ContextualElectronics/BenchBudEE/CE-2line.bmp

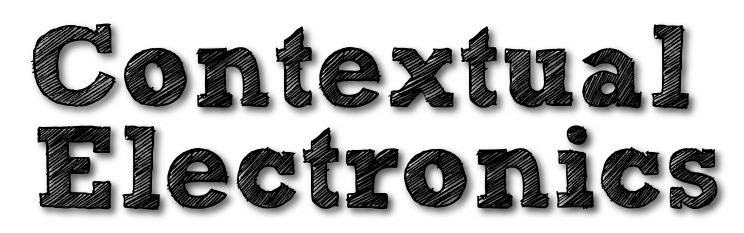
CE-2line.bmp
