ContextualElectronics/BenchBudEE/BenchBudEE_BOM_Passive.xlsx

Value | Quantity | RefDes | FootPrint | Link
100P | 1 | C1 | SM0805 | http://www.digikey.com/scripts/DkSearch/dksus.dll?Detail&itemSeq=148418893&uq=635333707511717488
1U | 10 | C5 C6 C7 C8 C9 C10 C11 C12 C13 C33 | SM0805 | http://www.digikey.com/scripts/DkSearch/dksus.dll?Detail&itemSeq=148418894&uq=635333707511717488
10U | 8 | C14 C15 C16 C17 C22 C23 C24 C25 | SM0805 | http://www.digikey.com/scripts/DkSearch/dksus.dll?Detail&itemSeq=148418891&uq=635333707511717488
.01U | 4 | C18 C19 C20 C21 | SM0805 | http://www.digikey.com/scripts/DkSearch/dksus.dll?Detail&itemSeq=148418892&uq=635333707511717488
NOPOP | 5 | C30 C31 C32 R26 R57 | SM0805 | -
10U | 7 | C2 C3 C4 C26 C27 C28 C29 | SM1206 | http://www.digikey.com/scripts/DkSearch/dksus.dll?Detail&itemSeq=148418896&uq=635333707511717488
Ferrite Bead | 1 | L5 | SM0805 | http://www.digikey.com/scripts/DkSearch/dksus.dll?Detail&itemSeq=148416636&uq=635333682965213087
0 | 33 | R3 R5 R6 R14 R15 R43 R48 R49 R56 R58 R61 R62 R63 R27 R28 R29 R30 R31 R32 R33 R34 R35 R36 R37 R38 R39 R40 R41 R42 R46 R47 R50 R51 | SM0805 | http://www.digikey.com/scripts/DkSearch/dksus.dll?Detail&itemSeq=148418897&uq=635333707511717488
1 | 1 | R16 | SM1206-NO | http://www.digikey.com/scripts/DkSearch/dksus.dll?Detail&itemSeq=148418899&uq=635333707511717488
10 | 1 | R44 | SM0805 | http://www.digikey.com/scripts/DkSearch/dksus.dll?Detail&itemSeq=148418903&uq=635333707511717488
15 | 1 | R17 | SM0805 | http://www.digikey.com/scripts/DkSearch/dksus.dll?Detail&itemSeq=148418900&uq=635333707511717488
100 | 2 | R45 | SM0805 | http://www.digikey.com/scripts/DkSearch/dksus.dll?Detail&itemSeq=148418902&uq=635333707511717488
100 | 2 | R4 | SM0805 | http://www.digikey.com/scripts/DkSearch/dksus.dll?Detail&itemSeq=148418904&uq=635333707511717488
200 | 2 | R1 R2 | SM0805 | http://www.digikey.com/scripts/DkSearch/dksus.dll?Detail&itemSeq=148418901&uq=635333707511717488
715 | 2 | R18 R21 | SM0805 | http://www.digikey.com/scripts/DkSearch/dksus.dll?Detail&itemSeq=148418889&uq=635333707511717488
1000 | 1 | R12 | SM0805 | http://www.digikey.com/scripts/DkSearch/dksus.dll?Detail&itemSeq=148418898&uq=635333707511717488
1K | 4 | R22 R25 R59 R60 | SM0805 | http://www.digikey.com/scripts/DkSearch/dksus.dll?Detail&itemSeq=148418907&uq=635333707511717488
1.3K | 2 | R53 R54 | SM0805 | http://www.digikey.com/scripts/DkSearch/dksus.dll?Detail&itemSeq=148418911&uq=635333707511717488
3K | 2 | R23 R24 | SM0805 | http://www.digikey.com/scripts/DkSearch/dksus.dll?Detail&itemSeq=148418906&uq=635333707511717488
4.99K | 2 | R11 R13 | SM0805 | OOPS
4.99K | 2 | R7 R8 | SM1206 | http://www.digikey.com/scripts/DkSearch/dksus.dll?Detail&itemSeq=148418908&uq=635333707511717488
9.1K | 2 | R52 R55 | SM0805 | http://www.digikey.com/scripts/DkSearch/dksus.dll?Detail&itemSeq=148418910&uq=635333707511717488
200K | 2 | R9 R10 | SM1206 | http://www.digikey.com/scripts/DkSearch/dksus.dll?Detail&itemSeq=148418914&uq=635333707511717488
.1UF | 0 | None | SM0805 | http://www.digikey.com/scripts/DkSearch/dksus.dll?Detail&itemSeq=148418895&uq=635333707511717488
