ContextualElectronics/BenchBudEE/SPICE/InAmp.asc

R1: res; 5K
R2: res; 200K
R3: res; 5K
R4: res; 200K
R5: res; 5K
R6: res; 10
R7: res; 5K
R8: res; 10MEG
U1: LT1001
U2: LT1001
U3: LT1001
V1: voltage; SINE(0 .02 5)
V2: voltage; 12
V3: voltage; 12
Named nets: 10V+, 10V-, 0, OUT
.tran 0 1 0
.step param V 0 0.031 0.005
1000 ohm Rg = 1.75 V
100 ohm Rg = .200 V
10 ohm  Rg = .020V
No Rg = 10V
