ContextualElectronics/BenchBudEE/SPICE/RelayCircuit.asc

D1: LED; W5AP-LZMZ-5K8L
L1: ind; .1µ
Q1: npn; 2N3904
R1: res; 100
R2: res; 200
R3: res; 0.01
R4: res; 10
V1: voltage; 12
V2: voltage; PULSE(0 12 .1 .01 .01 1 1 10)
Named nets: 0
.tran 0 .2 0
