ContextualElectronics/BenchBudEE/SPICE/CurrentSource.asc

C1: cap; 10n
D1: diode; 1N914
M1: nmos; BSB012NE2LX
M3: nmos; Si7540DP_N
M4: nmos; Si7540DP_N
R1: res; 40
R2: res; 2
R5: res; 1K
R6: res; 2
U1: LT1001
V1: voltage; 12
V2: voltage; 12
V3: voltage; PULSE(4 0 100m .1m .1m 50m)
V4: voltage; 5
V5: voltage; PULSE(0 5 0 .1m .1m 1m 2m 10000)
V6: voltage; 5
Named nets: 0, V+, V-, FET, Sense, 5V, MODE, DAC, PWM
.tran 0 .1 0
.STEP PARAM Rload 2 20 2
.PARAM Rload 2
