ContextualElectronics/BenchBudEE/BenchBuddy.kicad_pcb

## KiCad design BenchBuddy.kicad_pcb (2014-03-04)

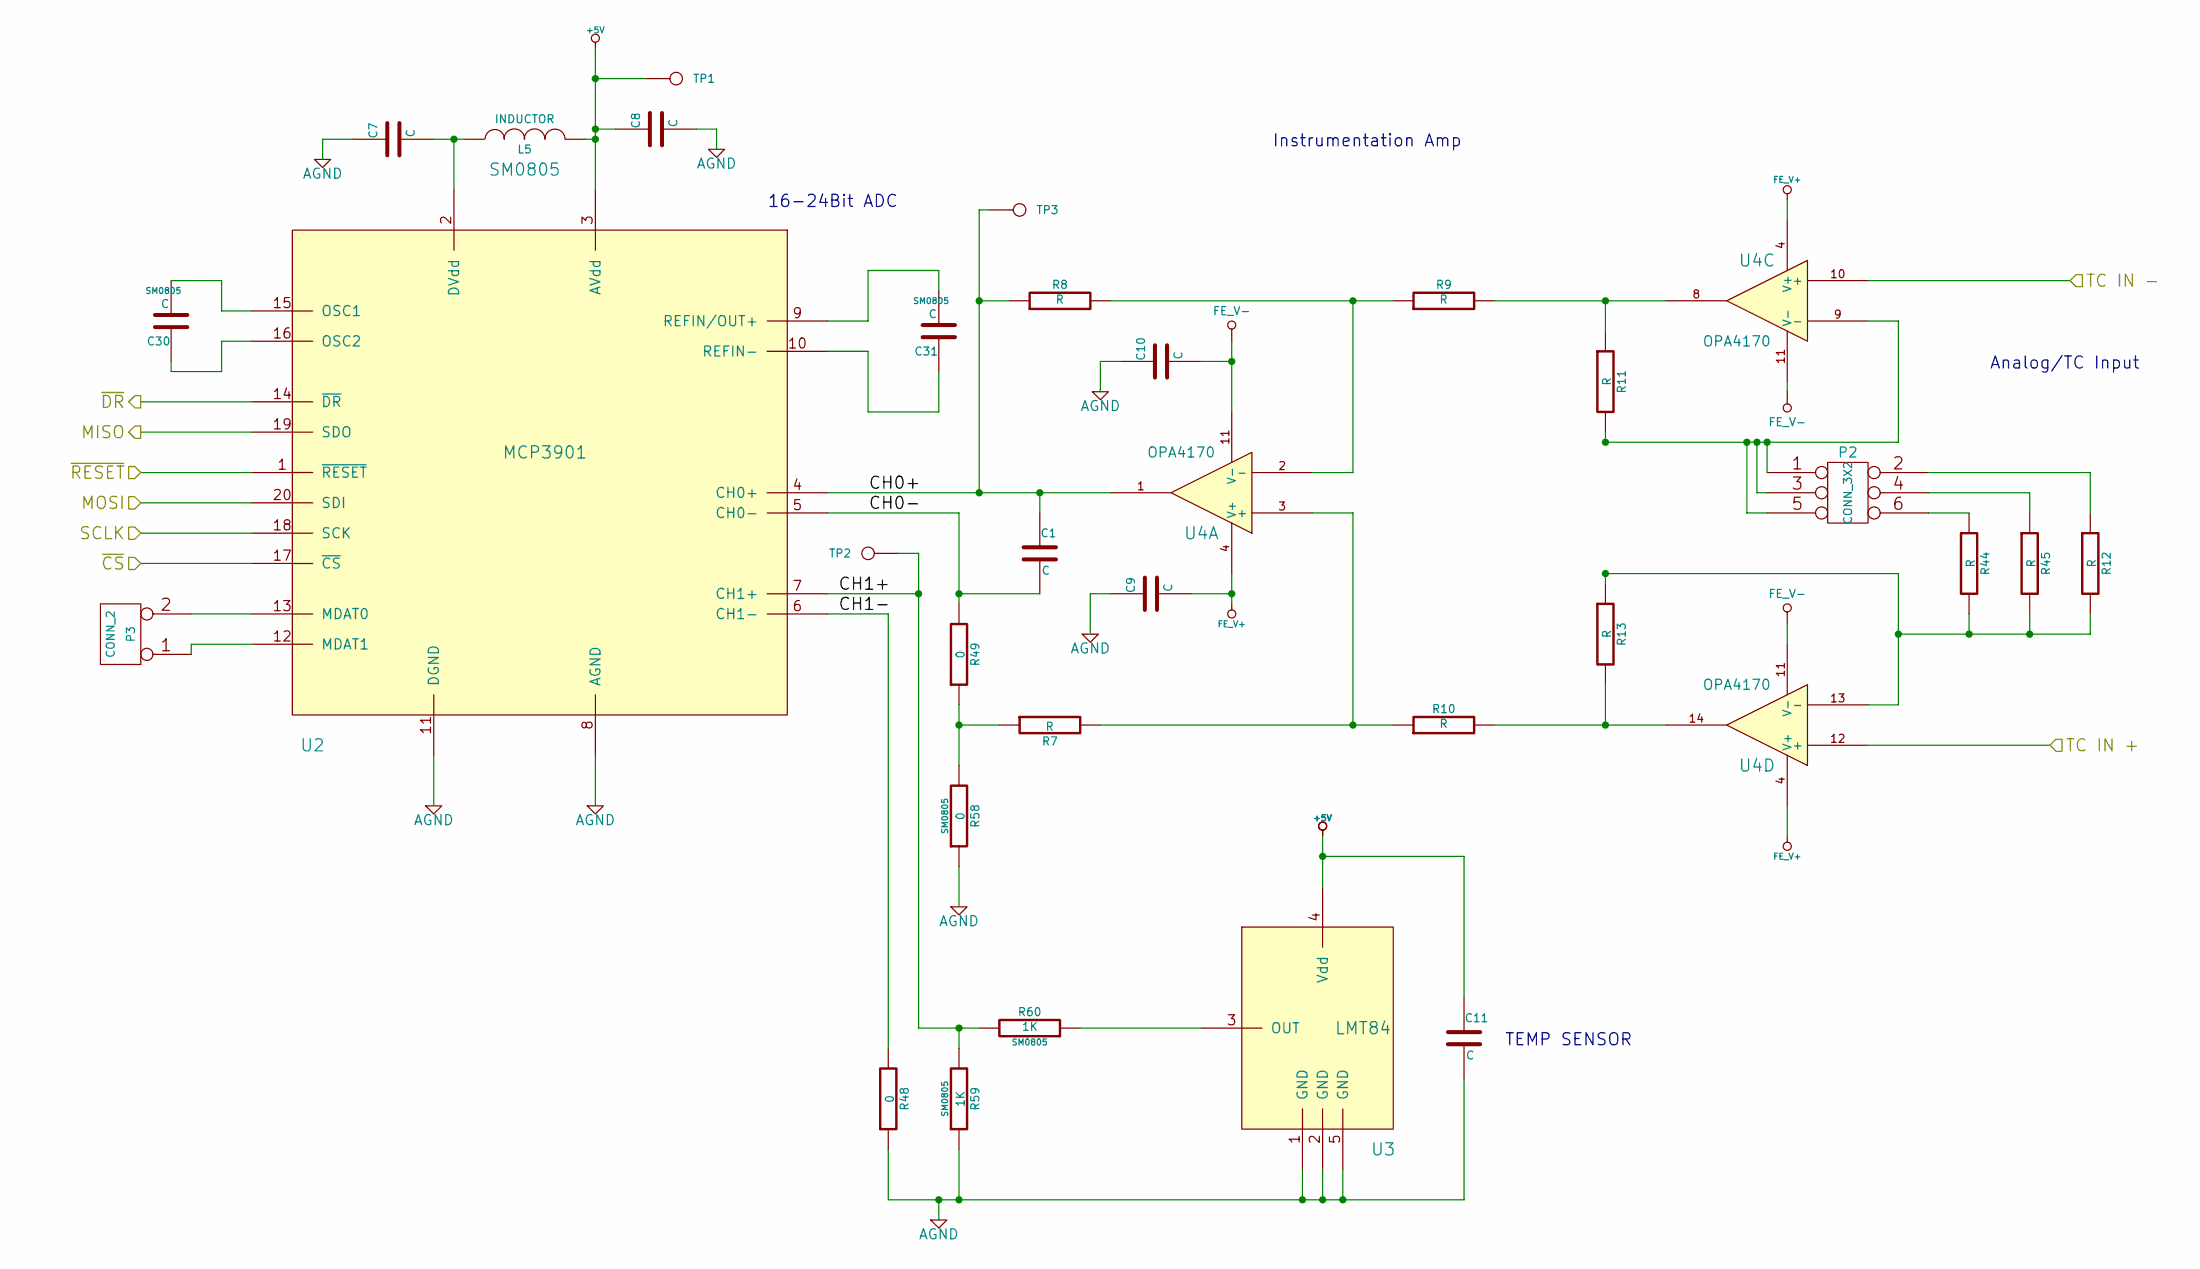
[picture p2: schematic Thermocouple.sch]

Parts:
C1, C7, C8, C9, C10, C11: C
C30, C31: C; SM0805
L5: INDUCTOR; SM0805
P2: CONN_3X2
P3: CONN_2
R7, R8, R9, R10, R11, R12, R13, R44, R45: R
R48, R49: 0
R58: 0; SM0805
R59, R60: 1K; SM0805
TP1: 5V
TP2: CH1
TP3: CH0
U2: MCP3901
U3: LMT84
U4: OPA4170

Connections:
+5V: C8.1, C11.1, L5.2, TP1.1, U2.3 (AVdd), U3.4 (Vdd); also elsewhere on the board
/Arduino/MISO: U2.19 (SDO); also elsewhere on the board
/Arduino/MOSI: U2.20 (SDI); also elsewhere on the board
/Arduino/SCLK: U2.18 (SCK); also elsewhere on the board
/Arduino/~ADC_CS: U2.17 (~CS); also elsewhere on the board
/Arduino/~DR: U2.14 (~DR); also elsewhere on the board
/Arduino/~RESET: U2.1 (~RESET); also elsewhere on the board
/Thermocouple/CH0+: C1.1, R8.1, TP3.1, U2.4 (CH0+), U4.1
/Thermocouple/CH0-: C1.2, R49.2, U2.5 (CH0-)
/Thermocouple/CH1+: R59.2, R60.2, TP2.1, U2.7 (CH1+)
/Thermocouple/CH1-: R48.2, U2.6 (CH1-)
/Thermocouple/TC IN +: U4.12 (+); also elsewhere on the board
/Thermocouple/TC IN -: U4.10 (+); also elsewhere on the board
AGND: C7.1, C8.2, C9.1, C10.1, C11.2, R48.1, R58.1, R59.1, U2.8 (AGND), U2.11 (DGND), U3.1 (GND), U3.2 (GND), U3.5 (GND); also elsewhere on the board
FE_V+: C9.2, U4.4 (V+); also elsewhere on the board
FE_V-: C10.2, U4.11 (V-); also elsewhere on the board
unnamed: R60.1, U3.3 (OUT)
unnamed: C30.2, U2.15 (OSC1)
unnamed: C30.1, U2.16 (OSC2)
unnamed: C31.2, U2.9 (REFIN/OUT+)
unnamed: C31.1, U2.10 (REFIN-)
unnamed: P3.1, U2.12 (MDAT1)
unnamed: P2.2, R12.1
unnamed: P2.4, R45.1
unnamed: P2.6, R44.1
unnamed: R8.2, R9.1, U4.2 (-)
unnamed: R7.2, R10.1, U4.3 (+)
unnamed: R9.2, R11.1, U4.8
unnamed: P2.1, P2.3, P2.5, R11.2, U4.9 (-)
unnamed: R12.2, R13.1, R44.2, R45.2, U4.13 (-)
unnamed: R10.2, R13.2, U4.14
unnamed: P3.2 (PM), U2.13 (MDAT0)
unnamed: R7.1, R49.1, R58.2
unnamed: C7.2, L5.1, U2.2 (DVdd)

Notes on the sheet:
Analog/TC Input
Instrumentation Amp
16-24Bit ADC
TEMP SENSOR

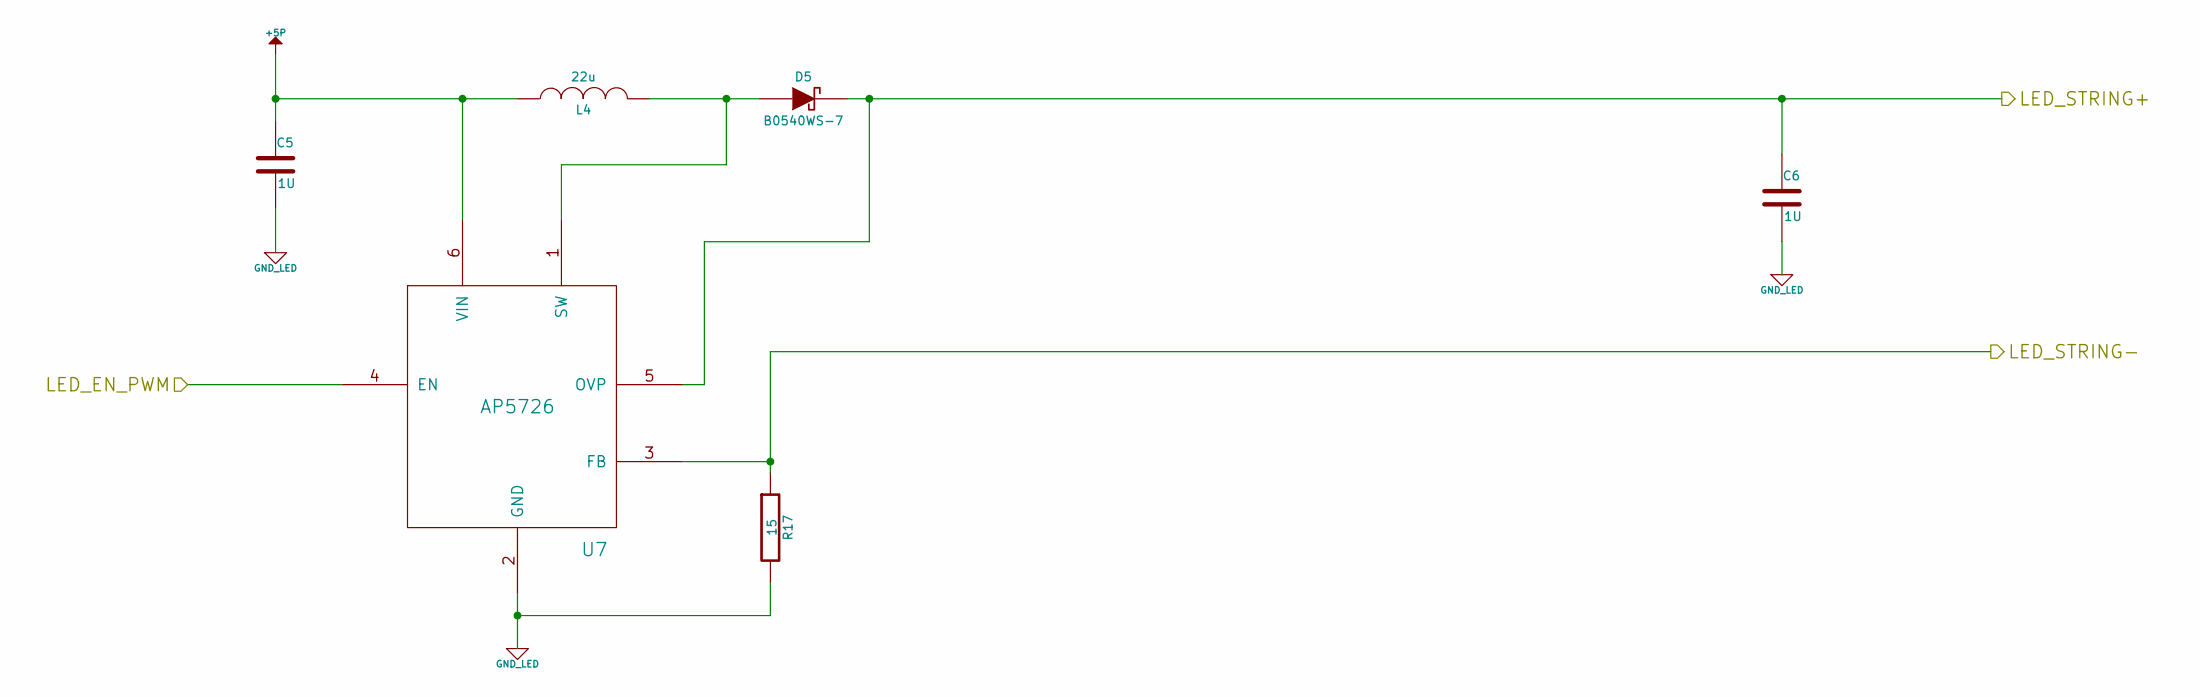
[picture p3: schematic LED_Driver.sch]

Parts:
C5, C6: 1U
D5: B0540WS-7
L4: 22u; MFG Part Number NR4012T220M
R17: 15
U7: AP5726

Connections:
+5P: C5.1, L4.1, U7.6 (VIN); also elsewhere on the board
/Arduino/LED_EN_PWM: U7.4 (EN); also elsewhere on the board
/LED_Driver/LED_STRING+: C6.1, D5.2 (K), U7.5 (OVP); also elsewhere on the board
/LED_Driver/LED_STRING-: R17.1, U7.3 (FB); also elsewhere on the board
GND_LED: C5.2, C6.2, R17.2, U7.2 (GND); also elsewhere on the board
unnamed: D5.1 (A), L4.2, U7.1 (SW)

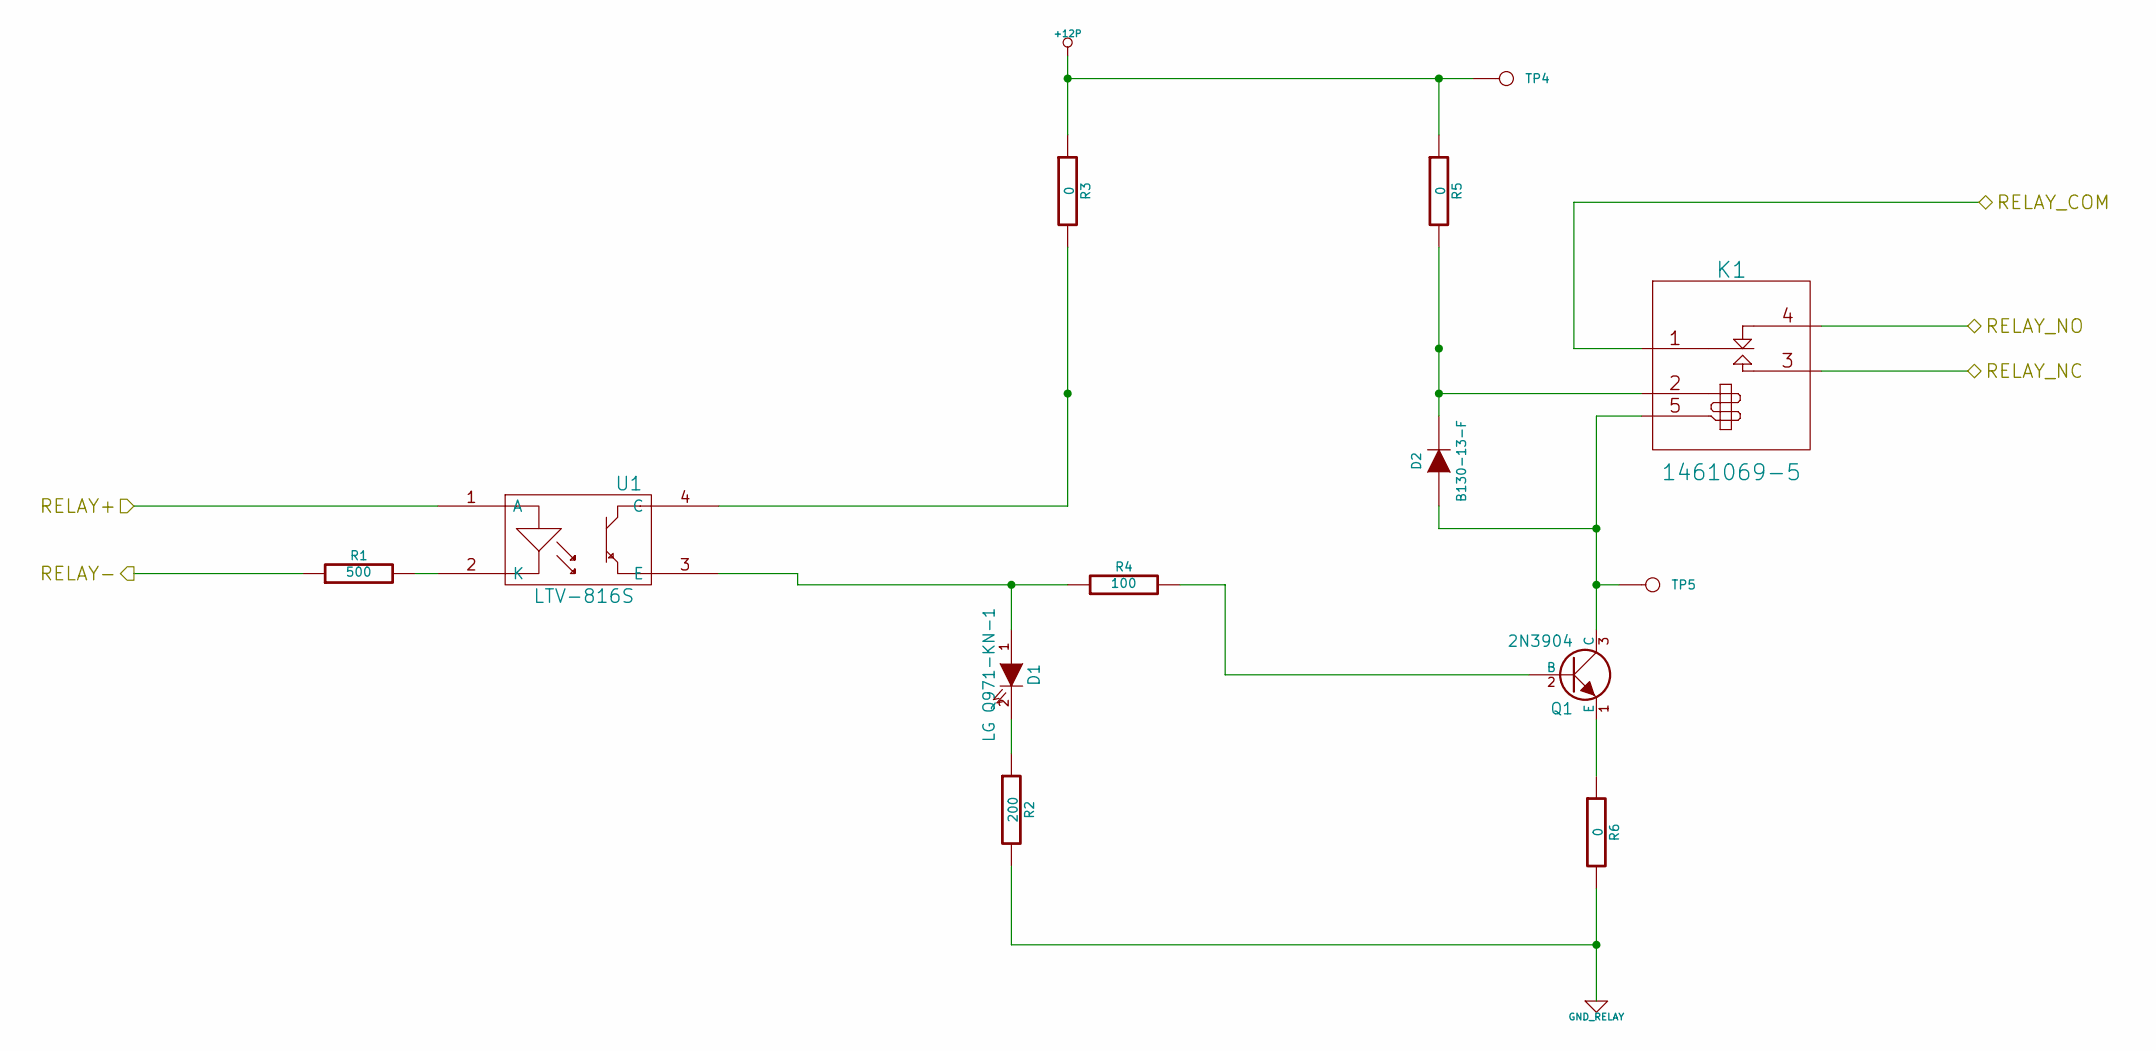
[picture p4: schematic Relay.sch]

Parts:
D1: LG Q971-KN-1
D2: B130-13-F
K1: 1461069-5
Q1: 2N3904; MFG Part Number MMBT3904-7-F
R1: 500
R2: 200
R3, R5, R6: 0
R4: 100
TP4: +12P
TP5: RELAY_LOW
U1: LTV-816S; MFG Part Number LTV-816S

Connections:
+12P: R3.1, R5.1, TP4.1; also elsewhere on the board
/Arduino/RELAY+: U1.1 (A); also elsewhere on the board
/Arduino/RELAY-: R1.1; also elsewhere on the board
/Relay/RELAY_COM: K1.1 (COM); also elsewhere on the board
/Relay/RELAY_NC: K1.3 (NO); also elsewhere on the board
/Relay/RELAY_NO: K1.4 (NC); also elsewhere on the board
GND_RELAY: R2.2, R6.2; also elsewhere on the board
unnamed: D1.2 (K), R2.1
unnamed: Q1.1 (E), R6.1
unnamed: Q1.2 (B), R4.2
unnamed: R1.2, U1.2 (K)
unnamed: D2.1 (A), K1.5 (COIL-), Q1.3 (C), TP5.1
unnamed: D2.2 (K), K1.2 (COIL+), R5.2
unnamed: D1.1 (A), R4.1, U1.3 (E)
unnamed: R3.2, U1.4 (C)

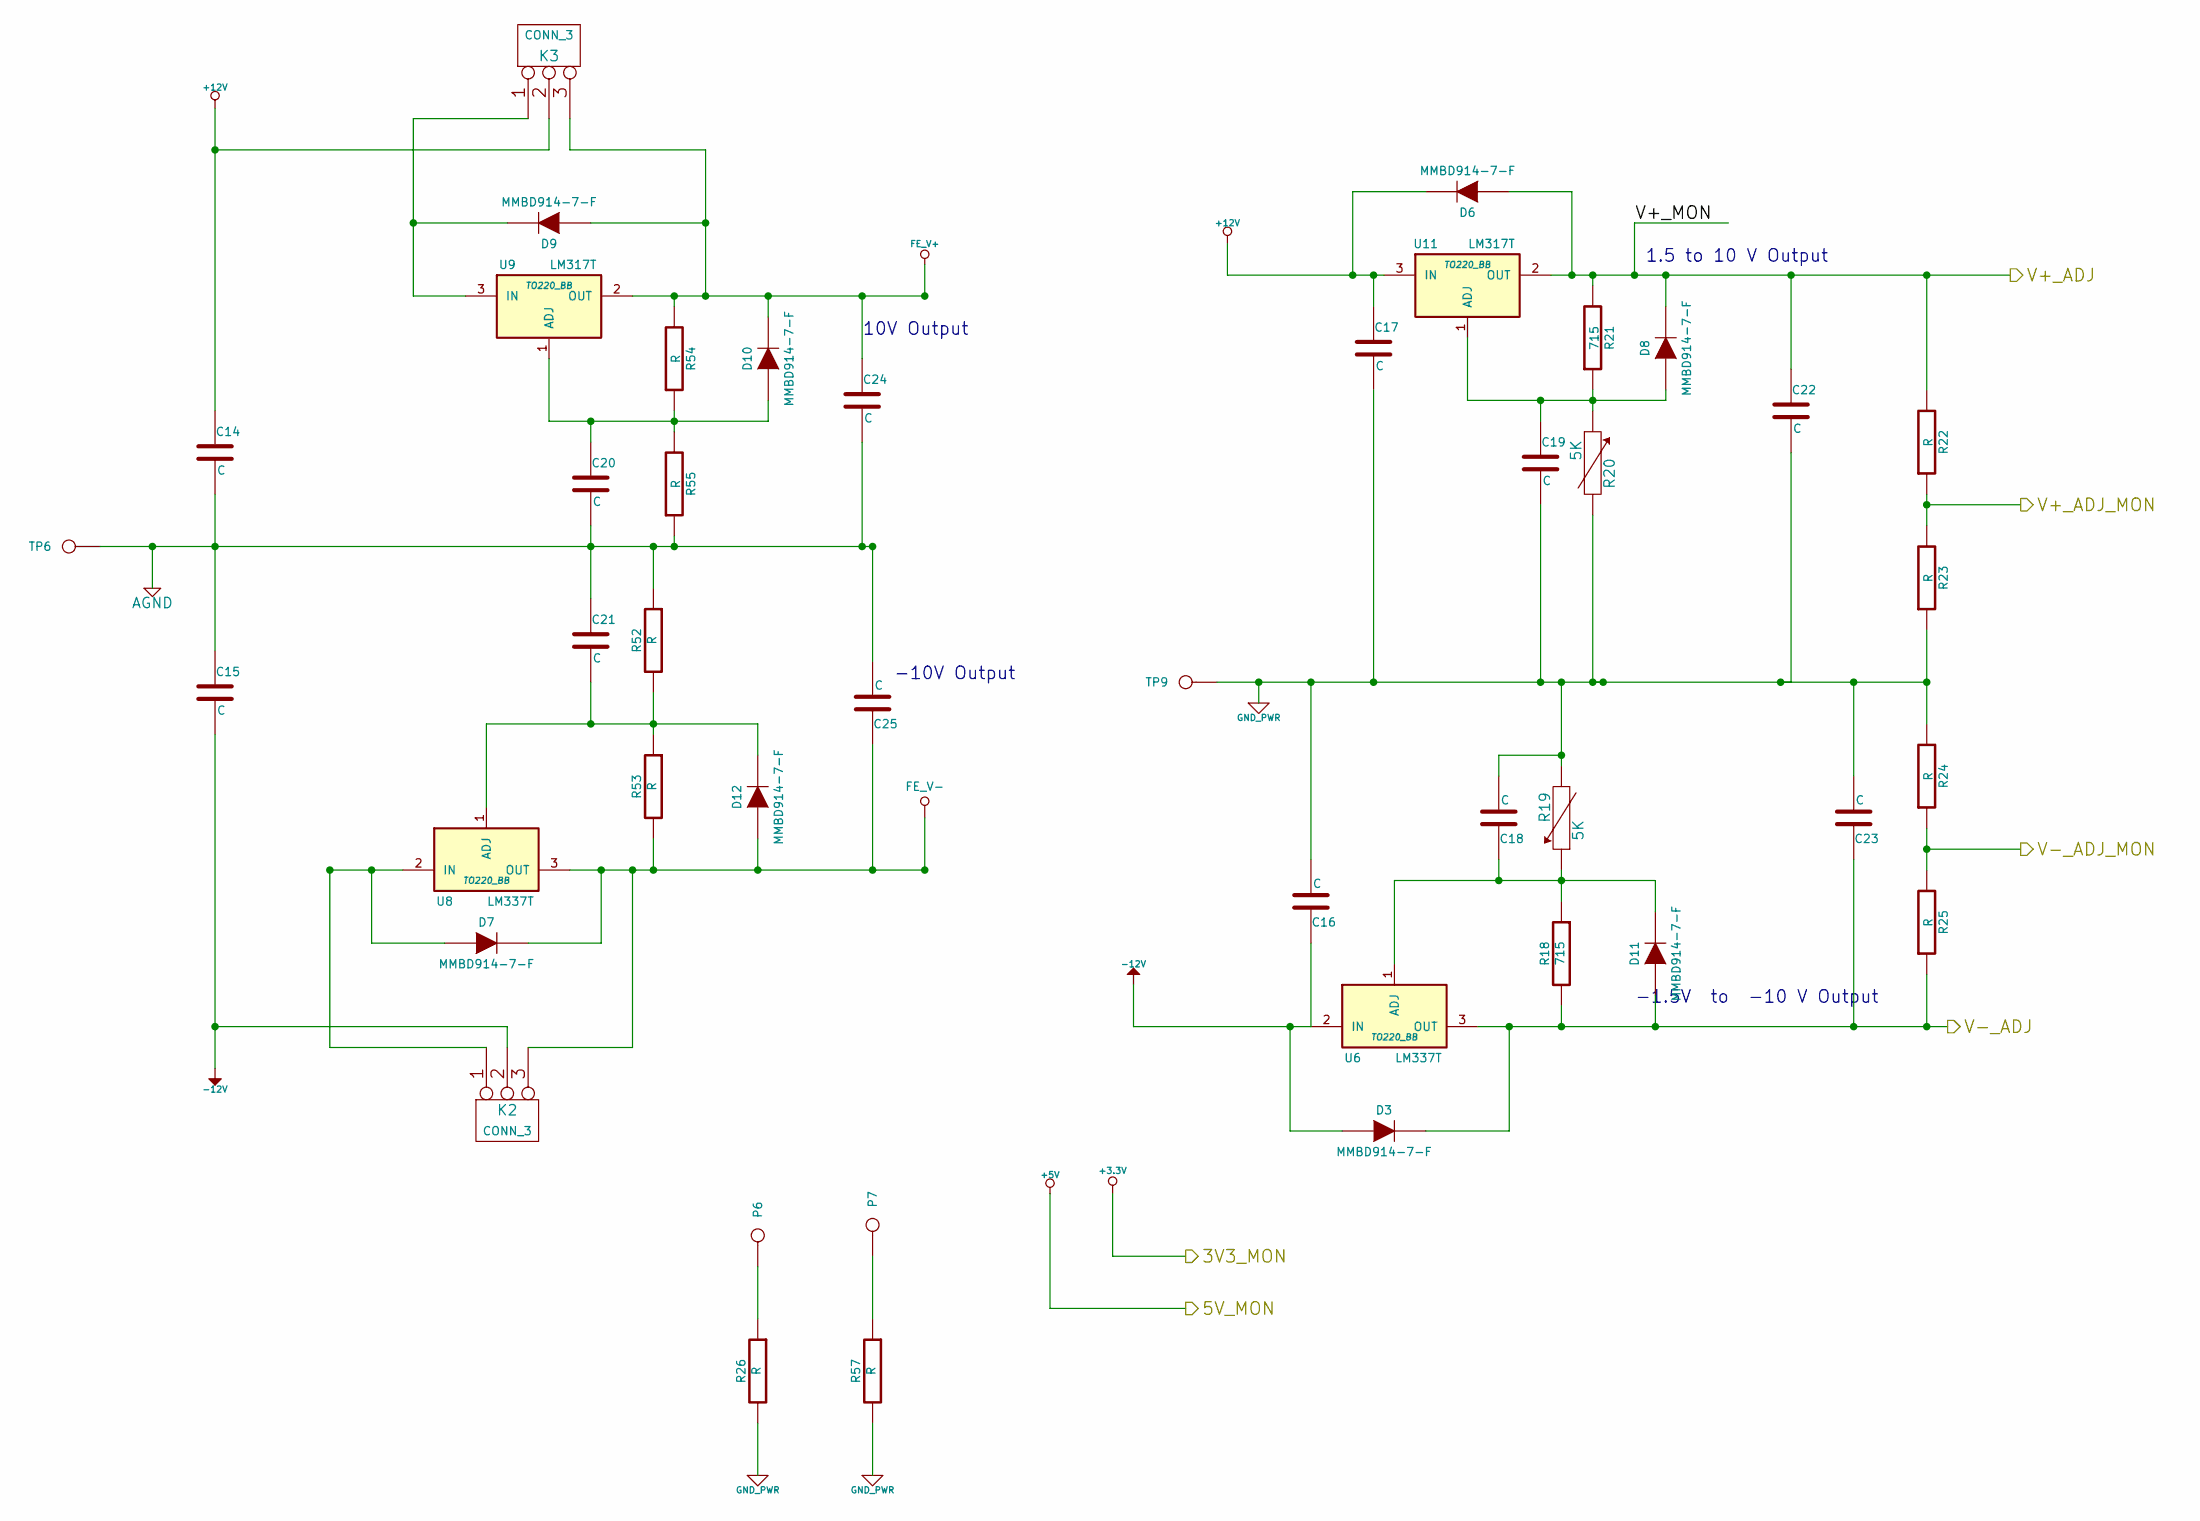
[picture p5: schematic PowerAdjustmentMonitor.sch]

Parts:
C14, C15, C16, C17, C18, C19, C20, C21, C22, C23, C24, C25: C
D3, D6, D7, D8, D9, D10, D11, D12: MMBD914-7-F
K2, K3: CONN_3
P6, P7: CONN_1
R18, R21: 715
R19, R20: 5K
R22, R23, R24, R25, R26, R52, R53, R54, R55, R57: R
TP6: AGND
TP9: GND_PWR
U6, U8: LM337T; TO220_BB
U9, U11: LM317T; TO220_BB

Connections:
+12V: C14.1, C17.1, D6.2 (K), K3.2 (PM), U11.3 (IN); also elsewhere on the board
-12V: C15.2, C16.1, D3.1 (A), K2.2 (PM), U6.2 (IN); also elsewhere on the board
/Arduino/V+_ADJ_MON: R22.1, R23.2; also elsewhere on the board
/Arduino/V-_ADJ_MON: R24.1, R25.2; also elsewhere on the board
/PowerAdjustmentMonitor/V+_ADJ: C22.1, D6.1 (A), D8.2 (K), R21.2, R22.2, U11.2 (OUT); also elsewhere on the board
/PowerAdjustmentMonitor/V-_ADJ: C23.1, D3.2 (K), D11.1 (A), R18.2, R25.1, U6.3 (OUT); also elsewhere on the board
AGND: C14.2, C15.1, C20.2, C21.1, C24.2, C25.2, R52.1, R55.1, TP6.1; also elsewhere on the board
FE_V+: C24.1, D9.1 (A), D10.2 (K), K3.3, R54.2, U9.2 (OUT); also elsewhere on the board
FE_V-: C25.1, D7.2 (K), D12.1 (A), K2.3, R53.2, U8.3 (OUT); also elsewhere on the board
GND_PWR: C16.2, C17.2, C18.2, C19.2, C22.2, C23.2, R19.2, R20.2, R23.1, R24.2, R26.2, R57.2, TP9.1; also elsewhere on the board
unnamed: C19.1, D8.1 (A), R20.1, R21.1, U11.1 (ADJ)
unnamed: C20.1, D10.1 (A), R54.1, R55.2, U9.1 (ADJ)
unnamed: C21.2, D12.2 (K), R52.2, R53.1, U8.1 (ADJ)
unnamed: P6.1, R26.1
unnamed: P7.1, R57.1
unnamed: C18.1, D11.2 (K), R18.1, R19.1, U6.1 (ADJ)
unnamed: D9.2 (K), K3.1, U9.3 (IN)
unnamed: D7.1 (A), K2.1, U8.2 (IN)

Notes on the sheet:
10V Output
1.5 to 10 V Output
-10V Output
-1.5V to -10 V Output

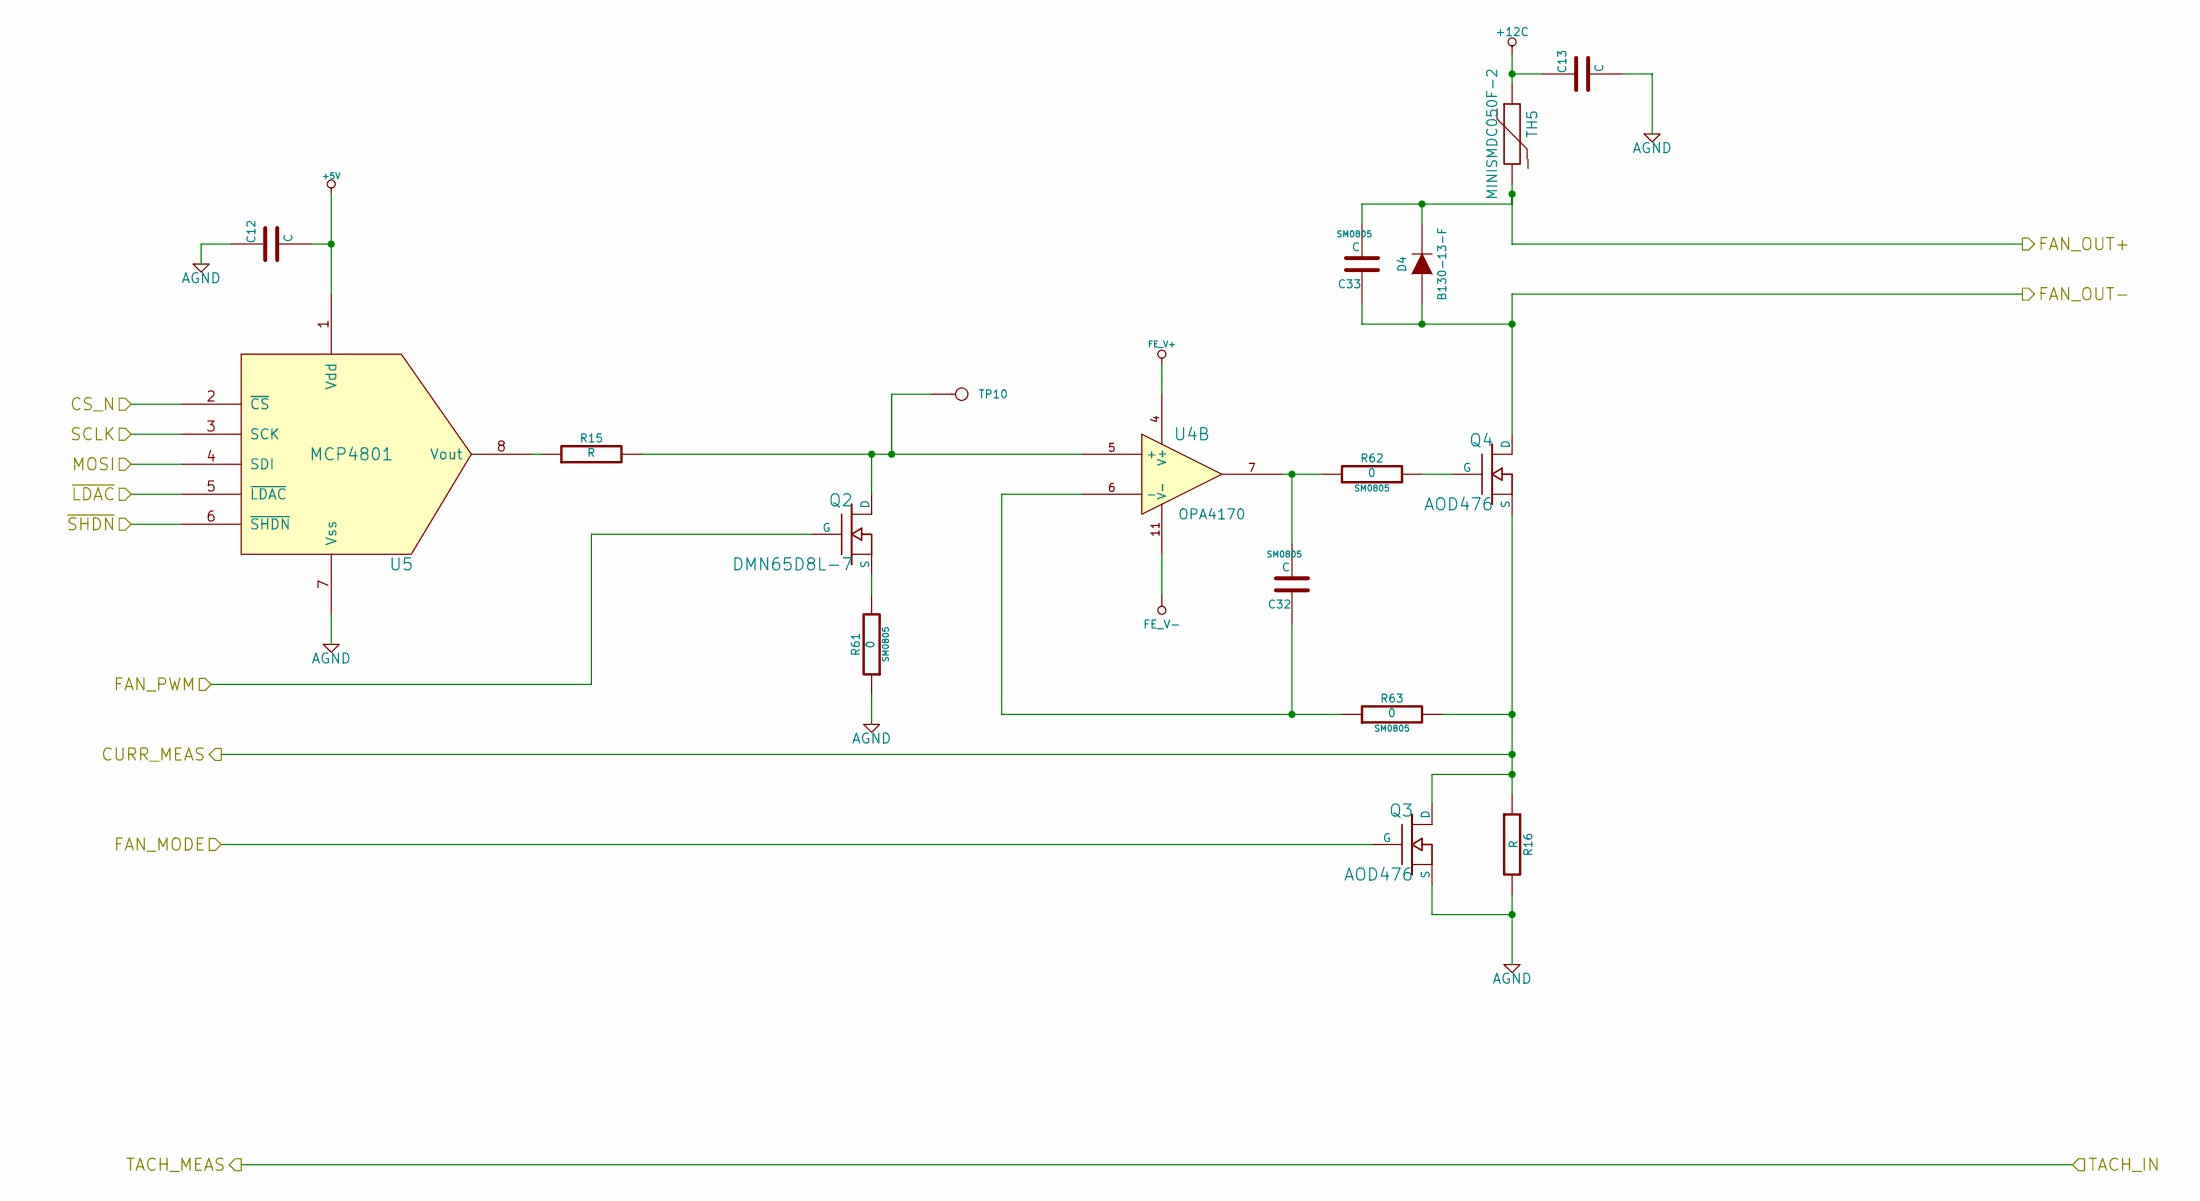
[picture p6: schematic Fan.sch]

Parts:
C12, C13: C
C32, C33: C; SM0805
D4: B130-13-F; MFG Part Number B130-13-F
Q2: DMN65D8L-7; MFG Part Number DMN65D8L-7
Q3, Q4: AOD476; MFG Part Number AOD476
R15, R16: R
R61, R62, R63: 0; SM0805
TH5: MINISMDC050F-2; MFG Part Number MINISMDC050F-2
TP10: DAC_OUT
U4: OPA4170
U5: MCP4801

Connections:
+5V: C12.2, U5.1 (Vdd); also elsewhere on the board
+12C: C13.1, TH5.1; also elsewhere on the board
/Arduino/CURR_MEAS: Q3.2 (D), Q4.3 (S), R16.1, R63.2; also elsewhere on the board
/Arduino/FAN_MODE: Q3.1 (G); also elsewhere on the board
/Arduino/FAN_PWM: Q2.G; also elsewhere on the board
/Arduino/MOSI: U5.4 (SDI); also elsewhere on the board
/Arduino/SCLK: U5.3 (SCK); also elsewhere on the board
/Arduino/~LDAC: U5.5 (~LDAC); also elsewhere on the board
/Arduino/~SHDN: U5.6 (~SHDN); also elsewhere on the board
/Fan/CS_N: U5.2 (~CS); also elsewhere on the board
/Fan/FAN_OUT+: C33.2, D4.2 (K), TH5.2; also elsewhere on the board
/Fan/FAN_OUT-: C33.1, D4.1 (A), Q4.2 (D); also elsewhere on the board
AGND: C12.1, C13.2, Q3.3 (S), R16.2, R61.1, U5.7 (Vss); also elsewhere on the board
FE_V+: U4.4 (V+); also elsewhere on the board
FE_V-: U4.11 (V-); also elsewhere on the board
unnamed: Q2.3 (S), Q2.S, R61.2
unnamed: Q4.1 (G), R62.2
unnamed: C32.1, R63.1, U4.6 (-)
unnamed: C32.2, R62.1, U4.7
unnamed: R15.1, U5.8 (Vout)
unnamed: Q2.2 (D), Q2.D, R15.2, TP10.1, U4.5 (+)

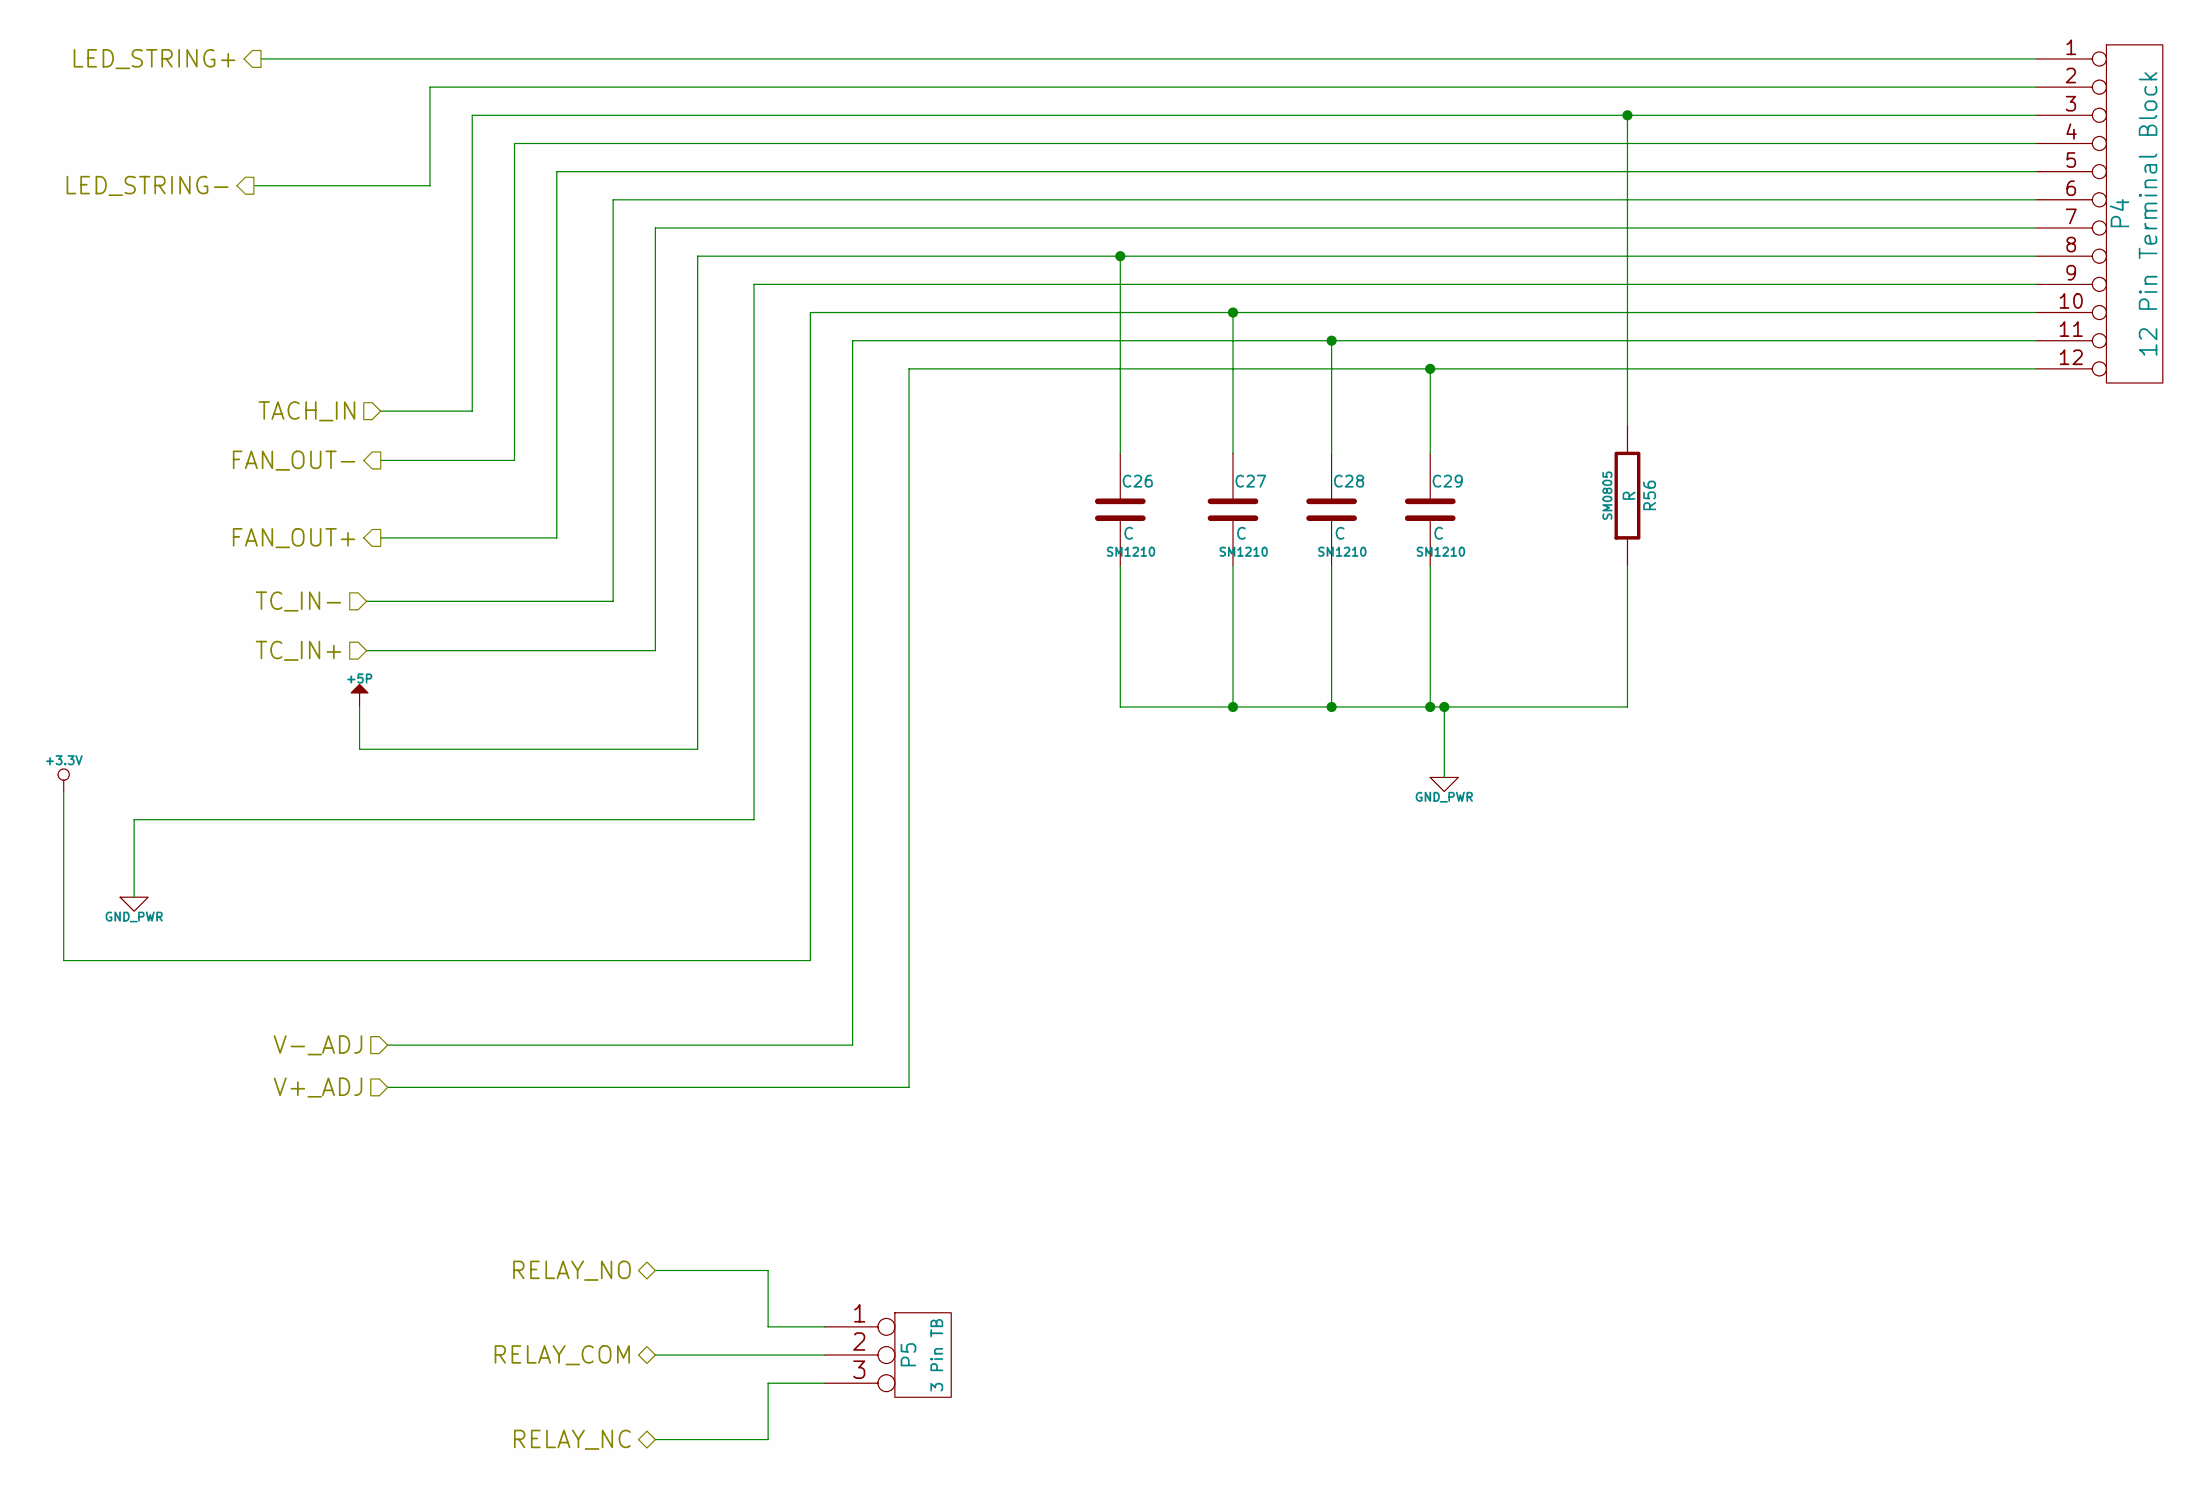
[picture p7: schematic TerminalBlock.sch]

Parts:
C26, C27, C28, C29: C; SM1210
P4: 12 Pin Terminal Block; MFG Part Number OSTTE120104
P5: 3 Pin TB; MFG Part Number 1935174
R56: R; SM0805

Connections:
+3.3V: C27.1, P4.10; also elsewhere on the board
+5P: C26.1, P4.8; also elsewhere on the board
/Fan/FAN_OUT+: P4.5; also elsewhere on the board
/Fan/FAN_OUT-: P4.4; also elsewhere on the board
/Fan/TACH_IN: P4.3, R56.2; also elsewhere on the board
/LED_Driver/LED_STRING+: P4.1; also elsewhere on the board
/LED_Driver/LED_STRING-: P4.2; also elsewhere on the board
/PowerAdjustmentMonitor/V+_ADJ: C29.1, P4.12; also elsewhere on the board
/PowerAdjustmentMonitor/V-_ADJ: C28.1, P4.11; also elsewhere on the board
/Relay/RELAY_COM: P5.2 (PM); also elsewhere on the board
/Relay/RELAY_NC: P5.3; also elsewhere on the board
/Relay/RELAY_NO: P5.1; also elsewhere on the board
/Thermocouple/TC IN +: P4.7; also elsewhere on the board
/Thermocouple/TC IN -: P4.6; also elsewhere on the board
GND_PWR: C26.2, C27.2, C28.2, C29.2, P4.9, R56.1; also elsewhere on the board
