ContextualElectronics/BenchBudEE/BenchBuddy.kicad_pcb

## KiCad design BenchBuddy.kicad_pcb (continued)

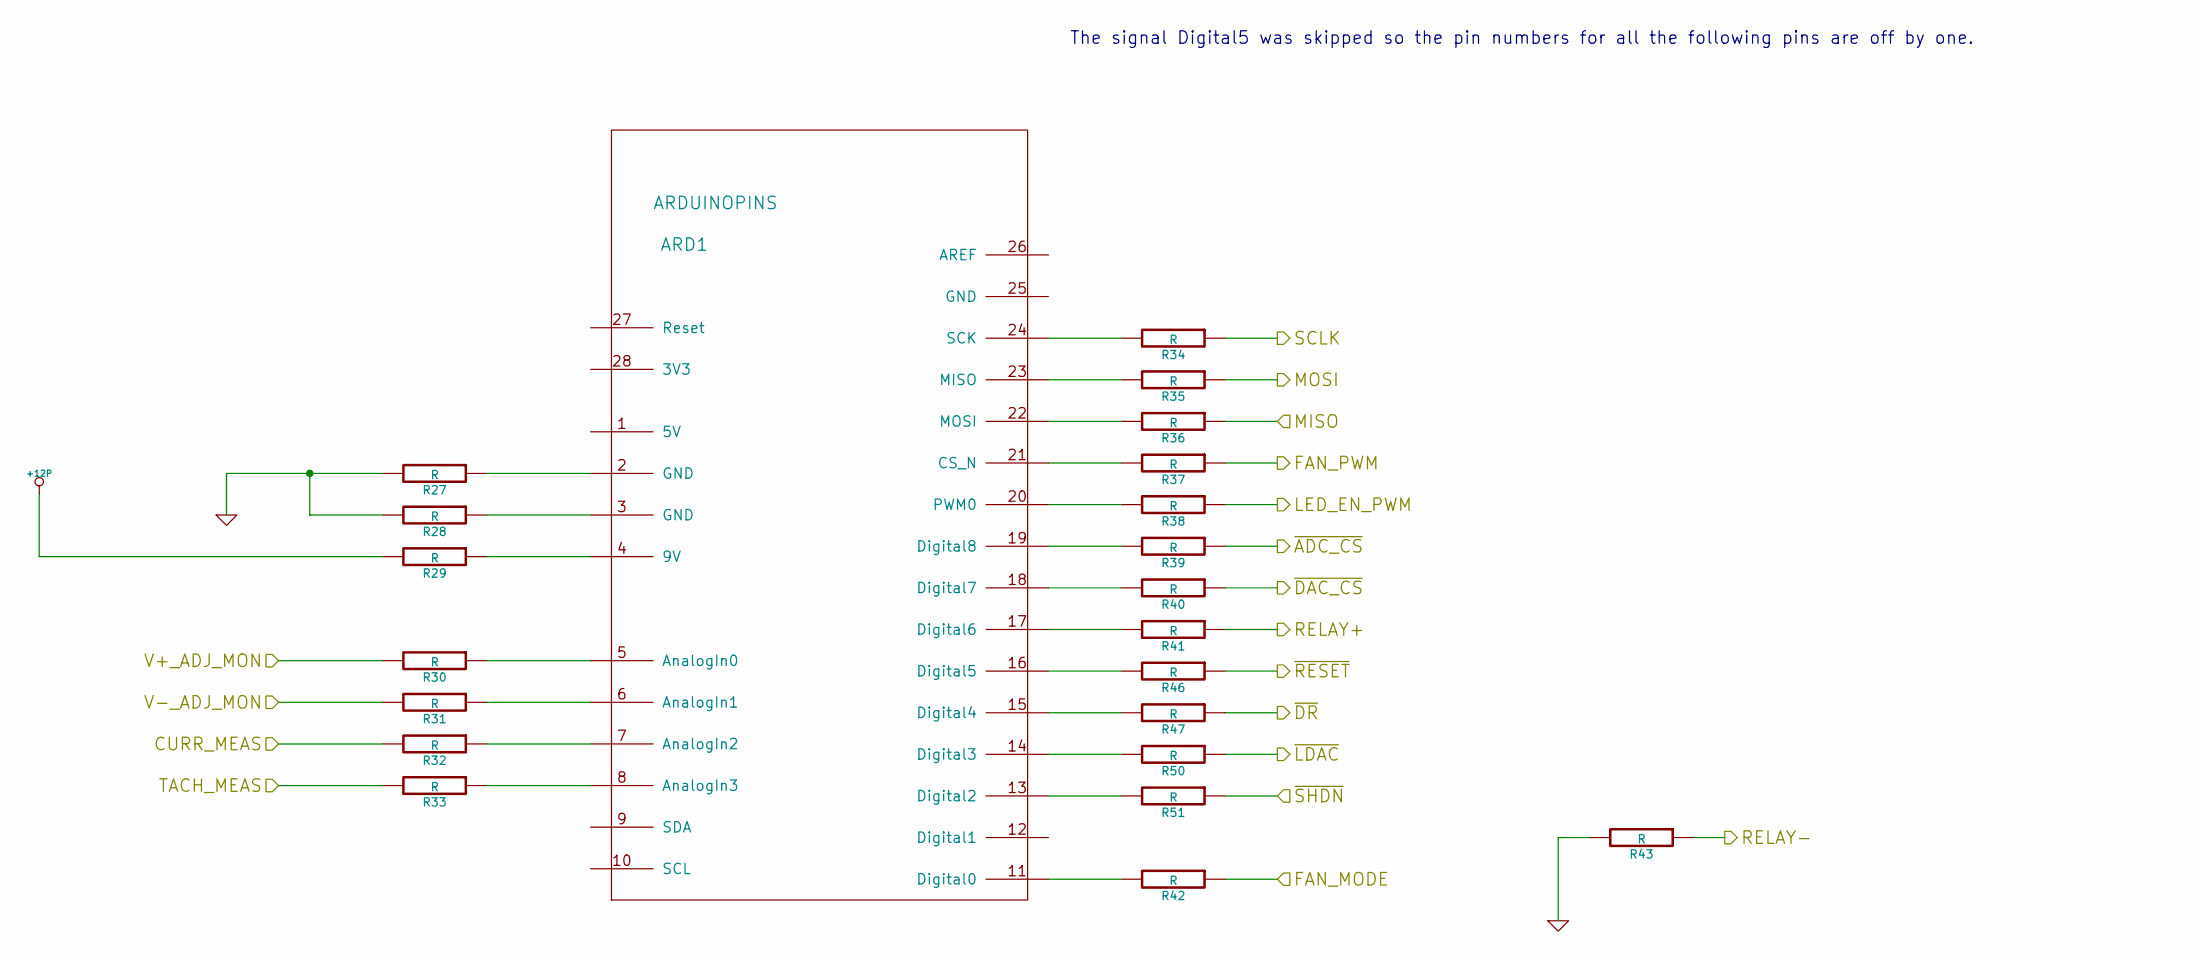
[picture p8: schematic Arduino.sch]

Parts:
ARD1: ARDUINOPINS
R27, R28, R29, R30, R31, R32, R33, R34, R35, R36, R37, R38, R39, R40, R41, R42, R43, R46, R47, R50, R51: R

Connections:
+12P: R29.2; also elsewhere on the board
/Arduino/CURR_MEAS: R32.2; also elsewhere on the board
/Arduino/FAN_MODE: R42.1; also elsewhere on the board
/Arduino/FAN_PWM: R37.1; also elsewhere on the board
/Arduino/LED_EN_PWM: R38.1; also elsewhere on the board
/Arduino/MISO: R36.1; also elsewhere on the board
/Arduino/MOSI: R35.1; also elsewhere on the board
/Arduino/RELAY+: R41.1; also elsewhere on the board
/Arduino/RELAY-: R43.1; also elsewhere on the board
/Arduino/SCLK: R34.1; also elsewhere on the board
/Arduino/V+_ADJ_MON: R30.2; also elsewhere on the board
/Arduino/V-_ADJ_MON: R31.2; also elsewhere on the board
/Arduino/~ADC_CS: R39.1; also elsewhere on the board
/Arduino/~DR: R47.1; also elsewhere on the board
/Arduino/~LDAC: R50.1; also elsewhere on the board
/Arduino/~RESET: R46.1; also elsewhere on the board
/Arduino/~SHDN: R51.1; also elsewhere on the board
/Fan/CS_N: R40.1; also elsewhere on the board
/Fan/TACH_IN: R33.2; also elsewhere on the board
GND: R27.2, R28.2, R43.2; also elsewhere on the board
unnamed: ARD1.2 (GND), R27.1
unnamed: ARD1.20 (PWM0), R38.2
unnamed: ARD1.11 (Digital0), R42.2
unnamed: ARD1.4 (9V), R29.1
unnamed: ARD1.3 (GND), R28.1
unnamed: ARD1.16 (Digital5), R46.2
unnamed: ARD1.15 (Digital4), R47.2
unnamed: ARD1.14 (Digital3), R50.2
unnamed: ARD1.13 (Digital2), R51.2
unnamed: ARD1.17 (Digital6), R41.2
unnamed: ARD1.18 (Digital7), R40.2
unnamed: ARD1.7 (AnalogIn2), R32.1
unnamed: ARD1.8 (AnalogIn3), R33.1
unnamed: ARD1.6 (AnalogIn1), R31.1
unnamed: ARD1.5 (AnalogIn0), R30.1
unnamed: ARD1.21 (CS_N), R37.2
unnamed: ARD1.19 (Digital8), R39.2
unnamed: ARD1.24 (SCK), R34.2
unnamed: ARD1.23 (MISO), R35.2
unnamed: ARD1.22 (MOSI), R36.2

Notes on the sheet:
The signal Digital5 was skipped so the pin numbers for all the following pins are off by one.

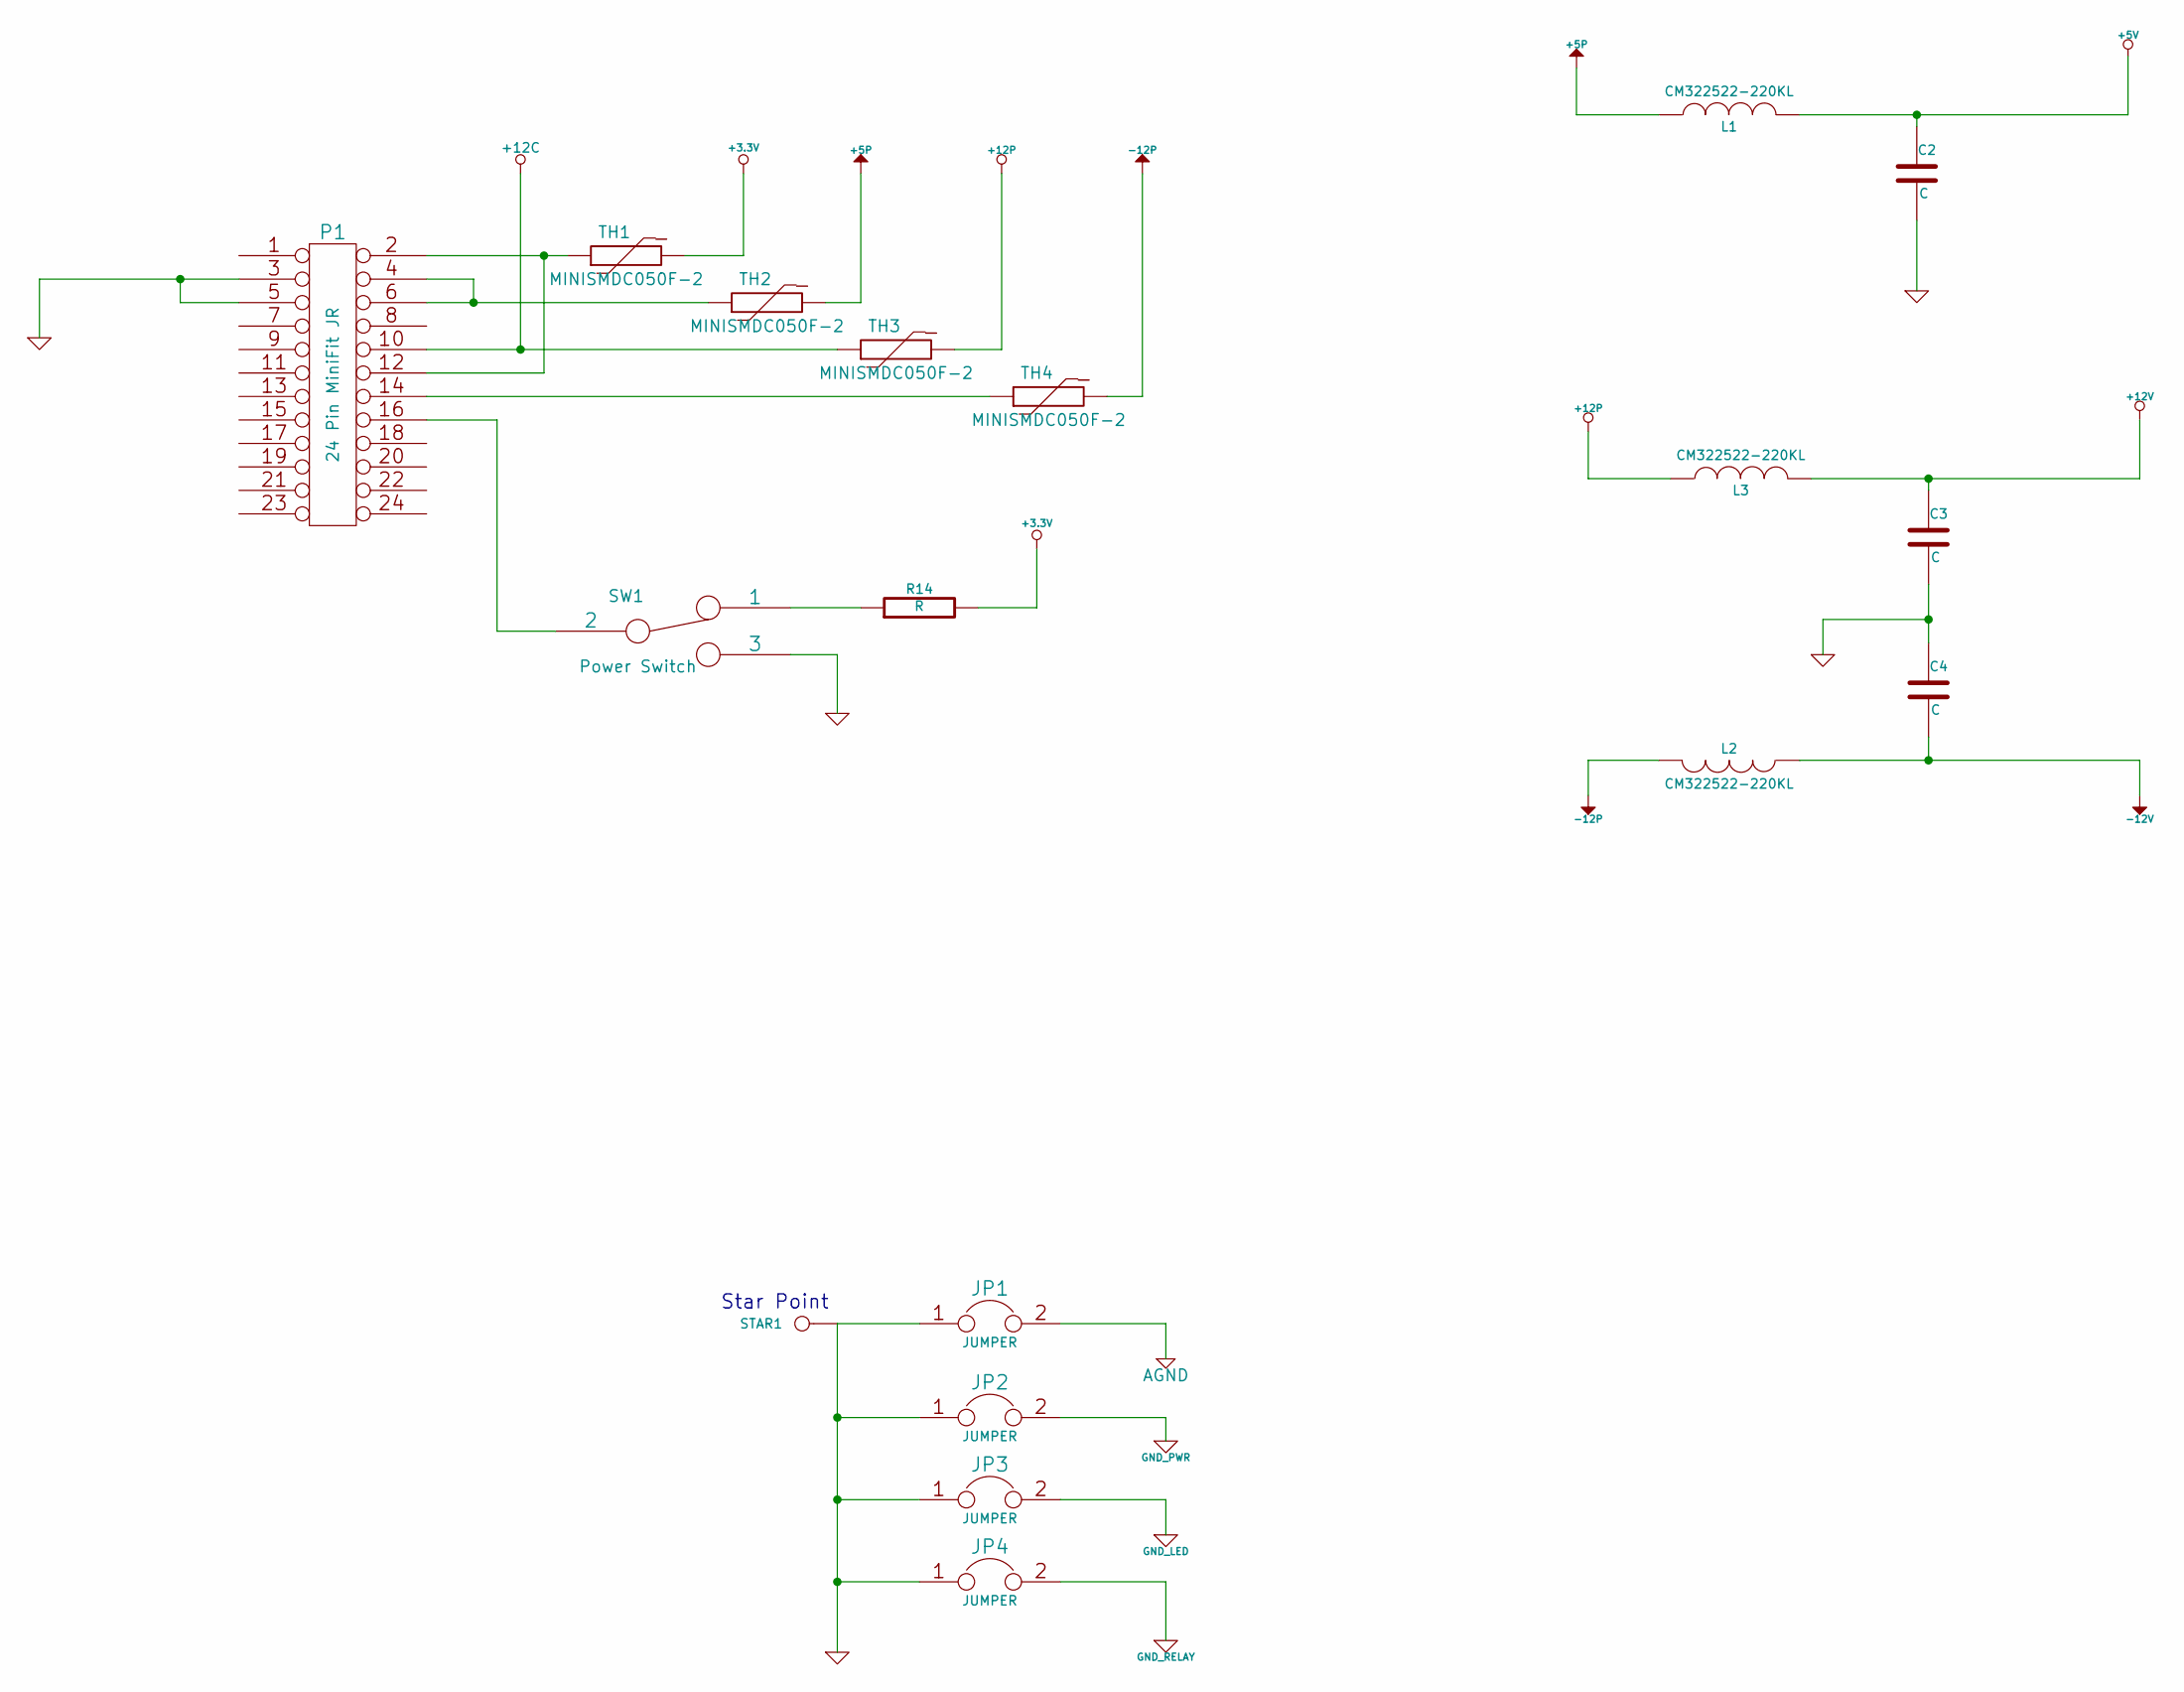
[picture p9: schematic Power.sch]

Parts:
C2, C3, C4: C
JP1, JP2, JP3, JP4: JUMPER
L1, L2, L3: CM322522-220KL; MFG Part Number CM322522-220KL
P1: 24 Pin MiniFit JR; MFG Part Number 39-30-1240
R14: R
STAR1: CONN_1
SW1: Power Switch; MFG Part Number OS102011MA1QN1
TH1, TH2, TH3, TH4: MINISMDC050F-2; MFG Part Number MINISMDC050F-2

Connections:
+3.3V: R14.2, TH1.2; also elsewhere on the board
+5P: L1.1, TH2.2; also elsewhere on the board
+5V: C2.1, L1.2; also elsewhere on the board
+12C: P1.10, TH3.1; also elsewhere on the board
+12P: L3.1, TH3.2; also elsewhere on the board
+12V: C3.1, L3.2; also elsewhere on the board
-12P: L2.2, TH4.2
-12V: C4.2, L2.1; also elsewhere on the board
AGND: JP1.2; also elsewhere on the board
GND: C2.2, C3.2, C4.1, JP1.1, JP2.1, JP3.1, JP4.1, P1.3, P1.5, STAR1.1, SW1.3; also elsewhere on the board
GND_LED: JP3.2; also elsewhere on the board
GND_PWR: JP2.2; also elsewhere on the board
GND_RELAY: JP4.2; also elsewhere on the board
unnamed: P1.14, TH4.1
unnamed: R14.1, SW1.1
unnamed: P1.16, SW1.2
unnamed: P1.2, P1.12, TH1.1
unnamed: P1.4, P1.6, TH2.1

Notes on the sheet:
Star Point

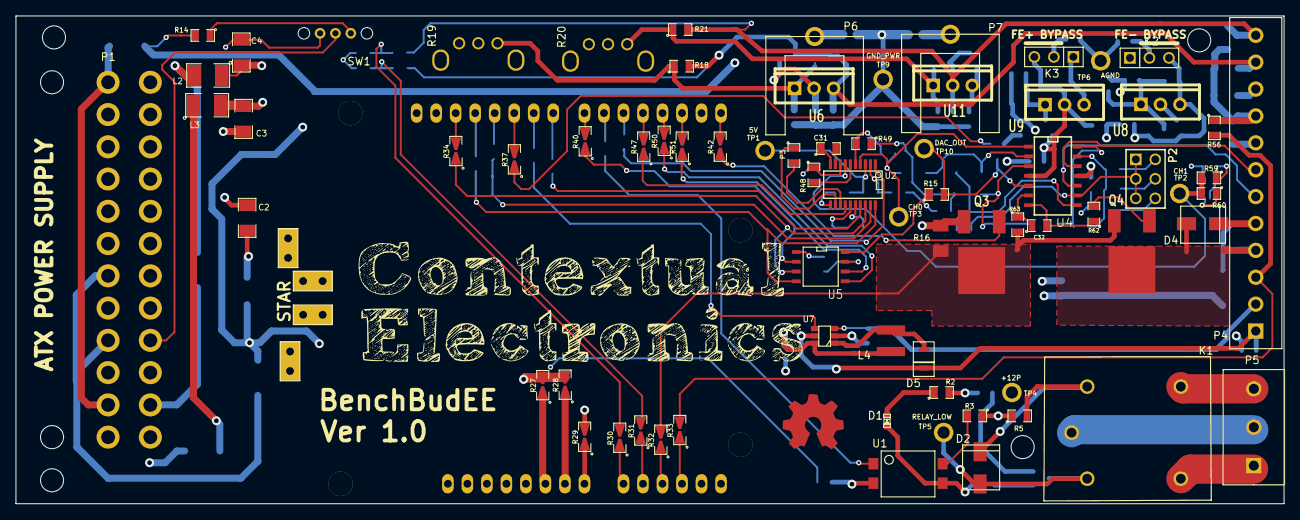
[picture p10: board BenchBuddy.kicad_pcb from above]

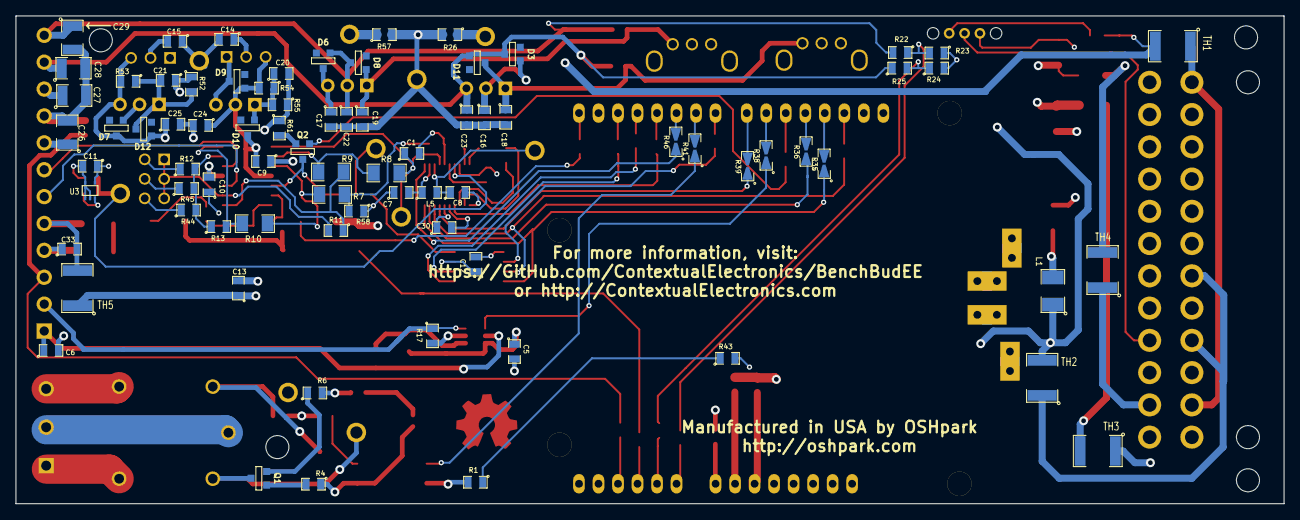
[picture p11: board BenchBuddy.kicad_pcb from below]

Board: 4 copper layers, 165.1 x 63.5 mm, 160 parts (78 on the bottom side), 114 nets.

Other parts of the board:
3 mm, 3 mm#2, 3 mm#3, 3 mm#4: VAL**; 3mm-NPTH
