ContextualElectronics/BenchBudEE/(commit log)

2013-09-04 Creation of initial blank files
    [BenchBuddy.kicad_pcb, BenchBuddy.sch]
2013-09-11 Added Schematic Skeleton
    Added sheets for each of the blocks within the block diagram. Will add
    details to each block later.
    [Arduino.sch, Fan.sch, LED_Driver.sch, Power.sch, Relay.sch, TerminalBlock.sch, Thermocouple.sch]
2013-09-12 Added High Level Interface Signals To Schematic
    Made the video for "Defining Inputs and Outputs Between Hierarchy
    Blocks" and actually implemented some signals between the blocks.
    [Arduino.sch, BenchBuddy.sch, Fan.sch, LED_Driver.sch, Power.sch, Relay.sch, TerminalBlock.sch, Thermocouple.sch]
2013-09-16 Added Analog/TC Block Diagram
    Made for the 'Creating The TC Module Block Diagram', this is a general
    look of how we want the Analog/TC input circuit to look. Next we'll
    start shopping for actual components to drop into the schematic.
    [Arduino.sch, BenchBuddy.sch, Fan.sch, LED_Driver.sch, Power.sch, Relay.sch, TerminalBlock.sch, Thermocouple.sch]
2013-09-16 Added Current/Fan Drive Block Diagram
    Added blocks and rough outline of components needed for current/fan
    drive module on the board.
    [Arduino.sch, BenchBuddy.sch, Fan.sch, LED_Driver.sch, Power.sch, Relay.sch, TerminalBlock.sch, Thermocouple.sch]
2013-09-20 Added Relay Module Block Diagram
    Everything we'll need for the relay block module, including opto and
    transistor. Also created general library of schematic symbols to be used
    for this project only (BenchBuddy.lib)
    [Arduino.sch, BenchBuddy.sch, Fan.sch, LED_Driver.sch, Power.sch, Relay.sch, TerminalBlock.sch, Thermocouple.sch]
2013-09-21 Added Power Protection And Filtering
    Added in passives and PTC resettable fuses for protecting users from the
    power supply.
    [Arduino.sch, BenchBuddy.sch, Fan.sch, LED_Driver.sch, Power.sch, PowerAdjustmentMonitor.sch, Relay.sch, TerminalBlock.sch]
2013-09-21 Added Power Control Conditioning And Monitoring Module
    Added in power monitoring.
    [Arduino.sch, BenchBuddy.sch, Fan.sch, LED_Driver.sch, Power.sch, PowerAdjustmentMonitor.sch, Relay.sch, TerminalBlock.sch]
2013-09-21 Added Top Level Signal Changes
    [Arduino.sch, BenchBuddy.sch, Fan.sch, LED_Driver.sch, Power.sch, PowerAdjustmentMonitor.sch, Relay.sch, TerminalBlock.sch]
2013-09-22 Added LED Circuit
    [Arduino.sch, BenchBuddy.sch, Fan.sch, LED_Driver.sch, Power.sch, PowerAdjustmentMonitor.sch, Relay.sch, TerminalBlock.sch]
2013-09-23 Added Arduino Module and Connected Top Level
    [Arduino.sch, BenchBuddy.sch, Fan.sch, LED_Driver.sch, Power.sch, PowerAdjustmentMonitor.sch, Relay.sch, TerminalBlock.sch]
2013-09-26 Fan/Current Module Refactoring
    [Arduino.sch, BenchBuddy.sch, Fan.sch, LED_Driver.sch, Power.sch, PowerAdjustmentMonitor.sch, Relay.sch, TerminalBlock.sch]
2013-09-26 Fan/Current Module 2
    Wasn't sure if all of the last changes made it into the commit.
    [Arduino.sch, BenchBuddy.sch, Fan.sch, LED_Driver.sch, Power.sch, PowerAdjustmentMonitor.sch, Relay.sch, TerminalBlock.sch]
2013-10-08 Clean Up Arduino Module
    [Arduino.sch, BenchBuddy.sch, Fan.sch, LED_Driver.sch, Power.sch, PowerAdjustmentMonitor.sch, Relay.sch, TerminalBlock.sch]
2013-10-08 Added Board Outline And Changed Preferences
2013-10-08 More Preference Changes
    Also the saved hotkey file
    [BenchBuddy.kicad_pcb]
2013-10-10 Associated Chosen Relay Components To Schematic
    [$Relay.sch, Arduino.sch, BenchBuddy.kicad_pcb, BenchBuddy.sch, Fan.sch, LED_Driver.sch, Power.sch, PowerAdjustmentMonitor.sch]
2013-10-10 Created Footprints and Placed Relay Module
    [$Relay.sch, Arduino.sch, BenchBuddy.kicad_pcb, BenchBuddy.sch, Fan.sch, LED_Driver.sch, Power.sch, PowerAdjustmentMonitor.sch]
2013-10-11 Associating Thermocouple Module Components
    [Arduino.sch, BenchBuddy.sch, Fan.sch, LED_Driver.sch, Power.sch, PowerAdjustmentMonitor.sch, Relay.sch, TerminalBlock.sch]
2013-10-11 Placing Thermocouple Module Components
    [$Thermocouple.sch, Arduino.sch, BenchBuddy.kicad_pcb, BenchBuddy.sch, Fan.sch, LED_Driver.sch, Power.sch, PowerAdjustmentMonitor.sch]
2013-10-12 Associating the Terminal Blocks
    [$Thermocouple.sch, Arduino.sch, BenchBuddy.sch, Fan.sch, LED_Driver.sch, Power.sch, PowerAdjustmentMonitor.sch, Relay.sch]
2013-10-12 Placing the Terminal Block/ATX Connectors
    [Arduino.sch, BenchBuddy.kicad_pcb, BenchBuddy.sch, Fan.sch, LED_Driver.sch, Power.sch, PowerAdjustmentMonitor.sch, Relay.sch]
2013-10-13 Added Arduino Footprint
    [Arduino.sch, BenchBuddy.kicad_pcb, BenchBuddy.sch, Fan.sch, LED_Driver.sch, Power.sch, PowerAdjustmentMonitor.sch, Relay.sch]
2013-10-14 Associating Current Module
    [Arduino.sch, BenchBuddy.sch, Fan.sch, LED_Driver.sch, Power.sch, PowerAdjustmentMonitor.sch, Relay.sch, TerminalBlock.sch]
2013-10-14 Placing Current Module Components
    [Arduino.sch, BenchBuddy.kicad_pcb, BenchBuddy.sch, Fan.sch, LED_Driver.sch, Power.sch, PowerAdjustmentMonitor.sch, Relay.sch]
2013-10-14 Associating The Filter Module
    [Arduino.sch, BenchBuddy.sch, Fan.sch, LED_Driver.sch, Power.sch, PowerAdjustmentMonitor.sch, Relay.sch, TerminalBlock.sch]
2013-10-14 Placing the Filter Module
    [Arduino.sch, BenchBuddy.kicad_pcb, BenchBuddy.sch, Fan.sch, LED_Driver.sch, Power.sch, PowerAdjustmentMonitor.sch, Relay.sch]
2013-10-21 Associating The Power Modify Module
    [Arduino.sch, BenchBuddy.sch, Fan.sch, LED_Driver.sch, Power.sch, PowerAdjustmentMonitor.sch, Relay.sch, TerminalBlock.sch]
2013-10-21 Power Modify CMP data
2013-10-22 Placing the Power Modify Module
    [Arduino.sch, BenchBuddy.kicad_pcb, BenchBuddy.sch, Fan.sch, LED_Driver.sch, Power.sch, PowerAdjustmentMonitor.sch, Relay.sch]
2013-10-23 Associating the LED Module
    [Arduino.sch, BenchBuddy.sch, Fan.sch, LED_Driver.sch, Power.sch, PowerAdjustmentMonitor.sch, Relay.sch, TerminalBlock.sch]
2013-10-23 Placing the LED Module
    [Arduino.sch, BenchBuddy.kicad_pcb, BenchBuddy.sch, Fan.sch, LED_Driver.sch, Power.sch, PowerAdjustmentMonitor.sch, Relay.sch]
2013-10-28 Added Ground Planes, Heatsinks, Moved components
    [Arduino.sch, BenchBuddy.sch, Fan.sch, LED_Driver.sch, Power.sch, PowerAdjustmentMonitor.sch, Relay.sch, TerminalBlock.sch]
2013-10-31 Added more ground planes
    [BenchBuddy.kicad_pcb]
2013-11-01 More ground plane changes
    [Arduino.sch, BenchBuddy.kicad_pcb, BenchBuddy.sch, Fan.sch, LED_Driver.sch, Power.sch, PowerAdjustmentMonitor.sch, Relay.sch]
2013-11-02 Cleanup to schematic after doing a scale printout
    [Arduino.sch, BenchBuddy.kicad_pcb, BenchBuddy.sch, Fan.sch, LED_Driver.sch, Power.sch, PowerAdjustmentMonitor.sch, Relay.sch]
2013-11-05 Layout Work Session 1 Output
    [BenchBuddy.kicad_pcb]
2013-11-07 Layout Work Session 2 Output
    [BenchBuddy.kicad_pcb]
2013-11-08 Layout Work Session 4 Output
    [Arduino.sch, BenchBuddy.kicad_pcb, BenchBuddy.sch, Fan.sch, LED_Driver.sch, Power.sch, PowerAdjustmentMonitor.sch, Relay.sch]
2013-11-10 Layout Work Session 5
    [Arduino.sch, BenchBuddy.kicad_pcb, BenchBuddy.sch, Fan.sch, LED_Driver.sch, Power.sch, PowerAdjustmentMonitor.sch, Relay.sch]
2013-11-11 Layout Work Session 6 Output
    [Arduino.sch, BenchBuddy.kicad_pcb, BenchBuddy.sch, Fan.sch, LED_Driver.sch, Power.sch, PowerAdjustmentMonitor.sch, Relay.sch]
2013-11-13 Layout Work Session 7 Output
    [Arduino.sch, BenchBuddy.kicad_pcb, BenchBuddy.sch, Fan.sch, LED_Driver.sch, Power.sch, PowerAdjustmentMonitor.sch, Relay.sch]
2013-11-14 Connecting Grounds Together
    [Arduino.sch, BenchBuddy.sch, Fan.sch, LED_Driver.sch, Power.sch, PowerAdjustmentMonitor.sch, Relay.sch, TerminalBlock.sch]
2013-11-15 Layout Work Session 8 Output
    [BenchBuddy.kicad_pcb]
2013-11-17 Layout Work Session 9 Output
    [BenchBuddy.kicad_pcb]
2013-11-17 Layout Work Session 10 Output
    [BenchBuddy.kicad_pcb]
2013-11-18 Layout Work Session 11 Output
    [Arduino.sch, BenchBuddy.kicad_pcb, BenchBuddy.sch, Fan.sch, LED_Driver.sch, Power.sch, PowerAdjustmentMonitor.sch, Relay.sch]
2013-11-22 Layout Work Session 12 Output
    [Arduino.sch, BenchBuddy.kicad_pcb, BenchBuddy.sch, Fan.sch, LED_Driver.sch, Power.sch, PowerAdjustmentMonitor.sch, Relay.sch]
2013-11-25 Layout Work Session 14 Output
    [$Thermocouple.sch, Arduino.sch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]
2013-11-25 Layout Work Session 15 Output
    Silkscreen
    [$Thermocouple.sch, Arduino.sch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]
2013-12-02 Layout Work Session 16
    Added ground connect to heatsink, fixed relay trace width, fixed silk
    screen issues.
    [Arduino.sch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]
2013-12-03 Layout Work Session 17 Output
    Fixing the power modify section pinout.
    [Arduino.sch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]
2013-12-19 Layout Work Session 18 Output
    Added test points, changed a bunch of silk screen, added another
    mounting hole and added a placeholder for the final commit number of the
    board being sent to fab.
    [Arduino.sch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]
2014-02-17 Analog IO Cleanup/Additions
    Added some placed holder caps and resistors
    [Arduino.sch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]
2014-03-01 Changes after external DFM
    Sent the board to freedfm.com, found some small errors that needed to be
    fixed before mfg.
    [BenchBuddy.kicad_pcb]
2014-03-04 Version 1.0 Version Sent To Fab
    All final changes made to send the file off for manufacturing.
    [BenchBuddy-B_Cu.gbl, BenchBuddy-B_Mask.gbs, BenchBuddy-B_SilkS.gbo, BenchBuddy-Edge_Cuts.gbr, BenchBuddy-F_Cu.gtl, BenchBuddy-F_Mask.gts, BenchBuddy-F_SilkS.gto, BenchBuddy-GND.gbr]
2014-04-17 Added Passive Values and SPICE models
    As part of week 1 of Session 1B, we added a SPICE model of the In amp
    and went through and assigned values to all of the passive components.
    [Arduino.sch, BenchBuddy.sch, Fan.sch, GainCalculation.ods, LED_Driver.sch, Power.sch, PowerAdjustmentMonitor.sch, Relay.sch]
2014-04-19 Added the schematic and BOM changes back in after hard reset
    [Arduino.sch, BenchBudEE_BOM_Active.xlsx, BenchBudEE_BOM_Passive.xlsx, BenchBuddy.sch, Fan.sch, LED_Driver.sch, Power.sch, PowerAdjustmentMonitor.sch]
2014-06-04 Test Code And Simulation Upload
    Since starting Session 1B not many commits have happened. There have
    been multiple SPICE simulations and Arduino programs written. This
    commit captures those programs at the beginning of Week 7.
    [GainCalculation.ods]
2014-06-05 Added PWM Test for Q3 Output To Drive Fan
    The once Q3 is engaged, the fan on the output can draw as much current
    as necessary (or whatever the PTC will allow). This test is to attempt
    to modify the output current with the PWM circuit near the DAC.
2014-06-11 Code to test out the LED circuit
